ECA-UFSC-FLN/2026.1-G7-RoboColetorBolas/hardware/pcb/README.md

Coloquei aqui os circuitos desenvolvidos
