ECA-UFSC-FLN/2026.1-G7-RoboColetorBolas/docs/README.md

Pasta para colocar a documentação do projeto
