ECA-UFSC-FLN/2026.1-G7-RoboColetorBolas/hardware/3d-models/README.md

Coloque aqui os arquivos para impressão 3D.
