ECA-UFSC-FLN/2026.1-G7-RoboColetorBolas/src/runs/detect/treino_bolas_v24/BoxR_curve.png

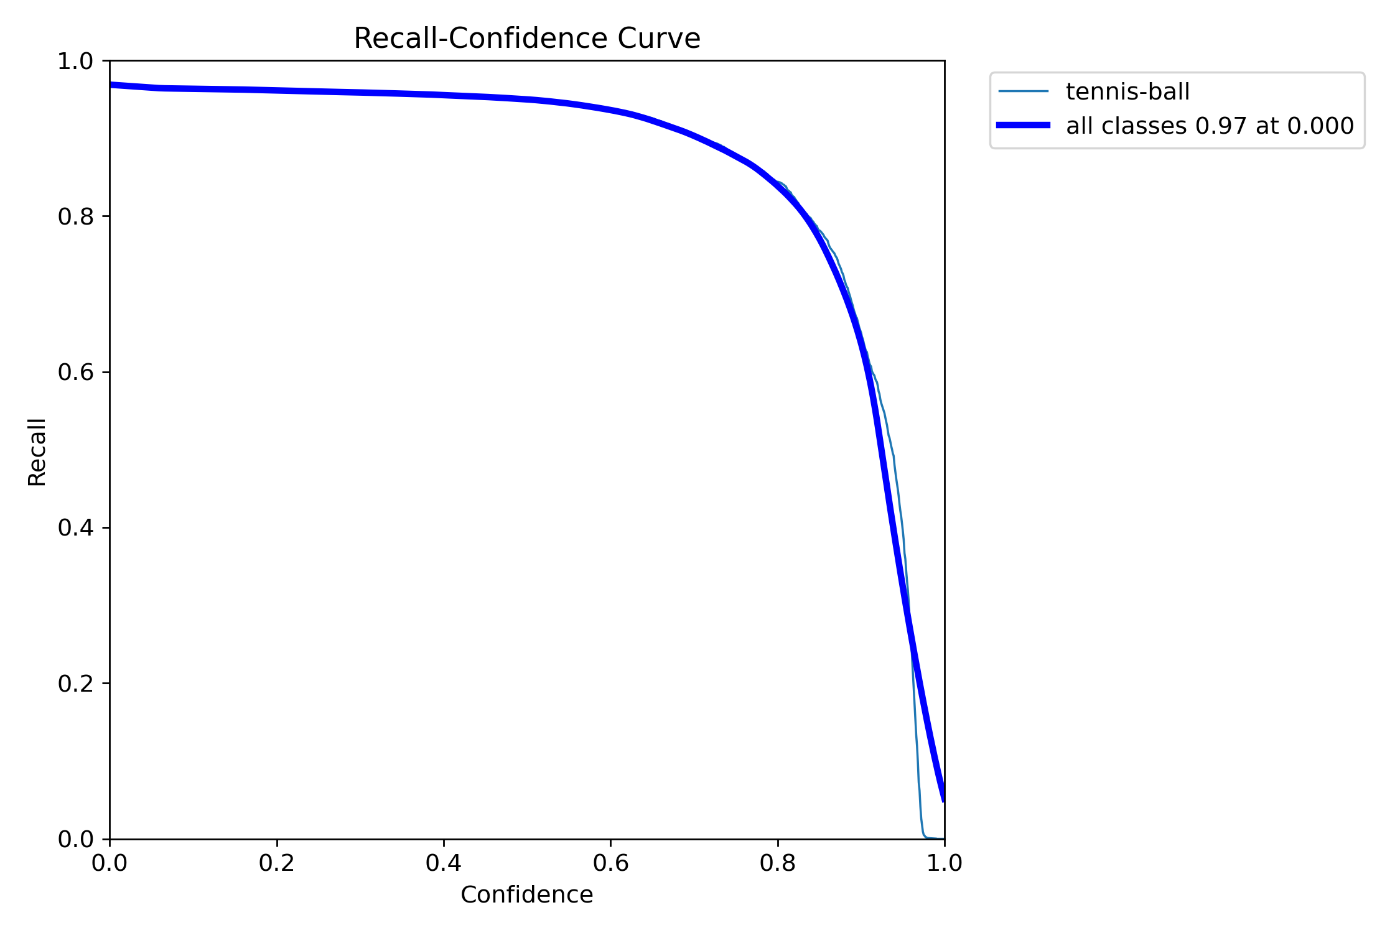
src/runs/detect/treino_bolas_v24/BoxR_curve.png
