ECA-UFSC-FLN/2026.1-G7-RoboColetorBolas/src/runs/detect/treino_bolas_v24/train_batch112861.jpg

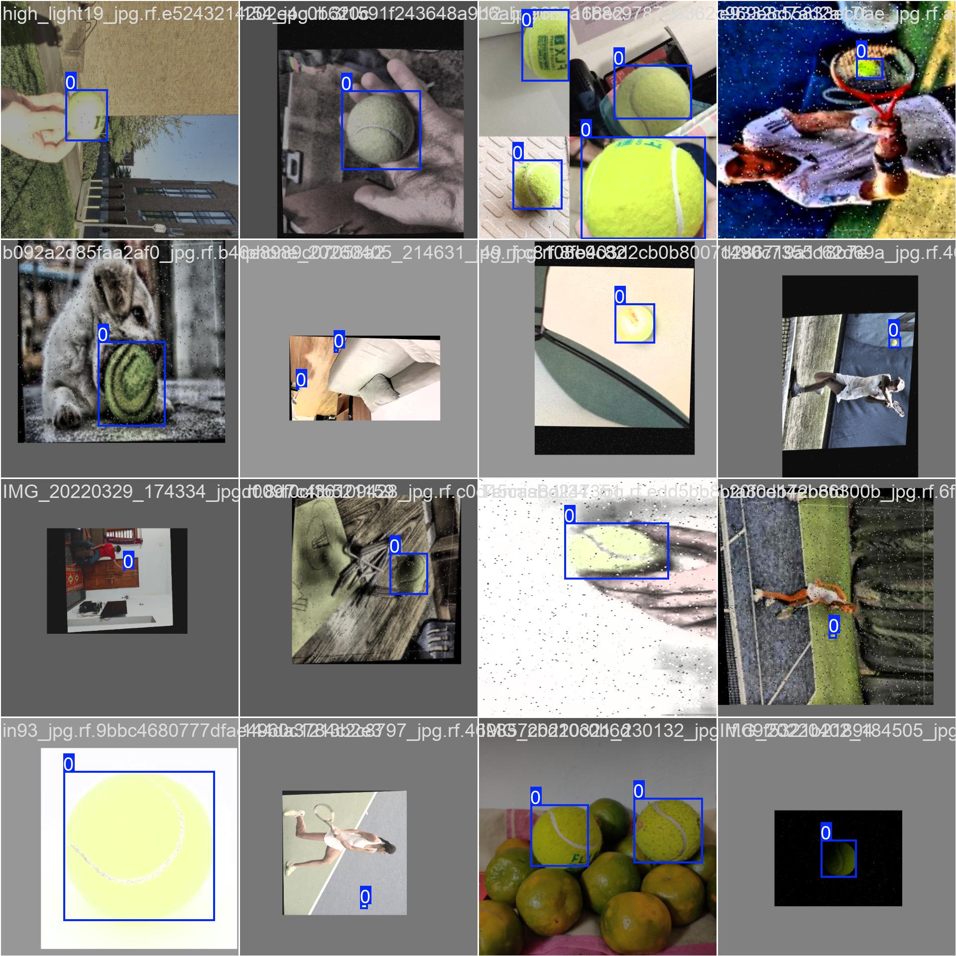
src/runs/detect/treino_bolas_v24/train_batch112861.jpg
