ECA-UFSC-FLN/2026.1-G7-RoboColetorBolas/src/runs/detect/treino_bolas_v24/val_batch1_labels.jpg

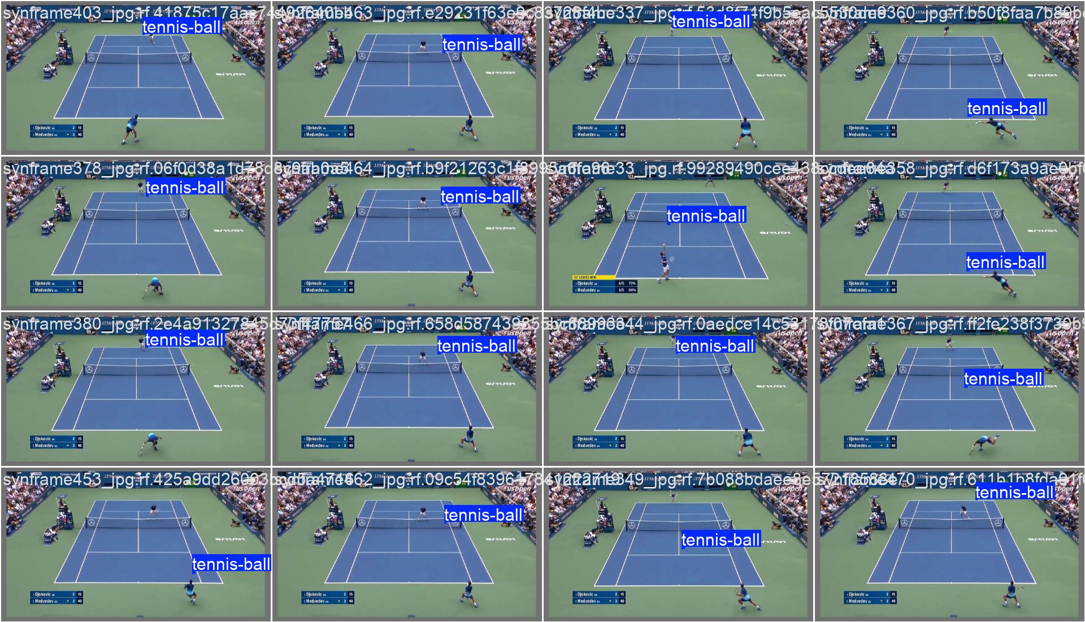
src/runs/detect/treino_bolas_v24/val_batch1_labels.jpg
