ECA-UFSC-FLN/2026.1-G7-RoboColetorBolas/docs/Entrega2/Entrega 2 - Projeto Integrador.pdf

# Robô Coletor de

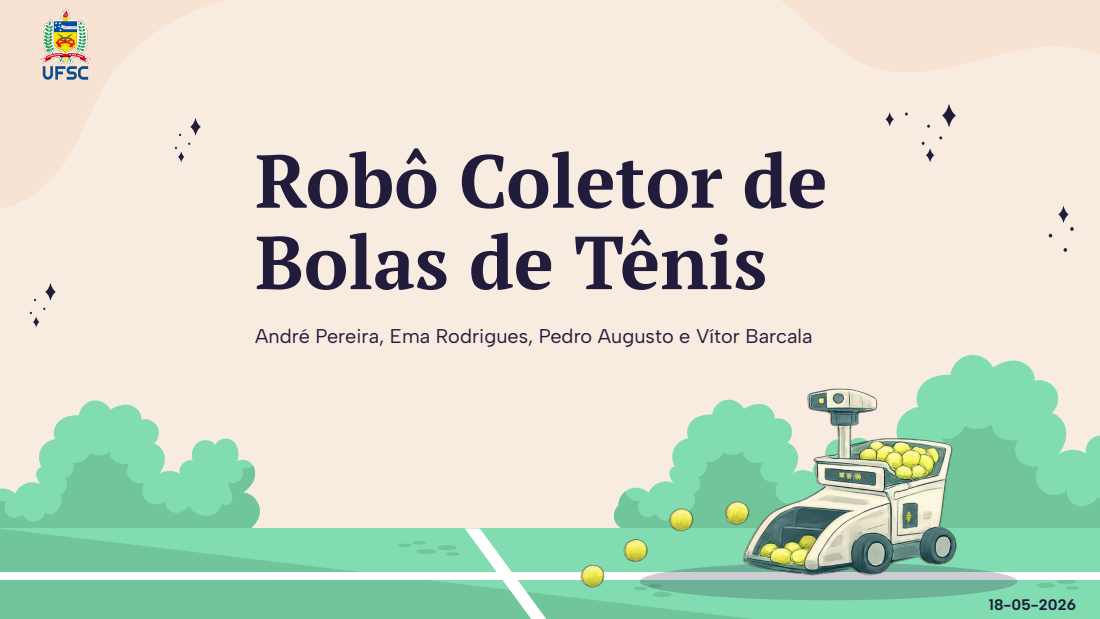
[picture p75: page 1]

Bolas de Tênis

André Pereira, Ema Rodrigues, Pedro Augusto e Vítor Barcala

# Tópicos

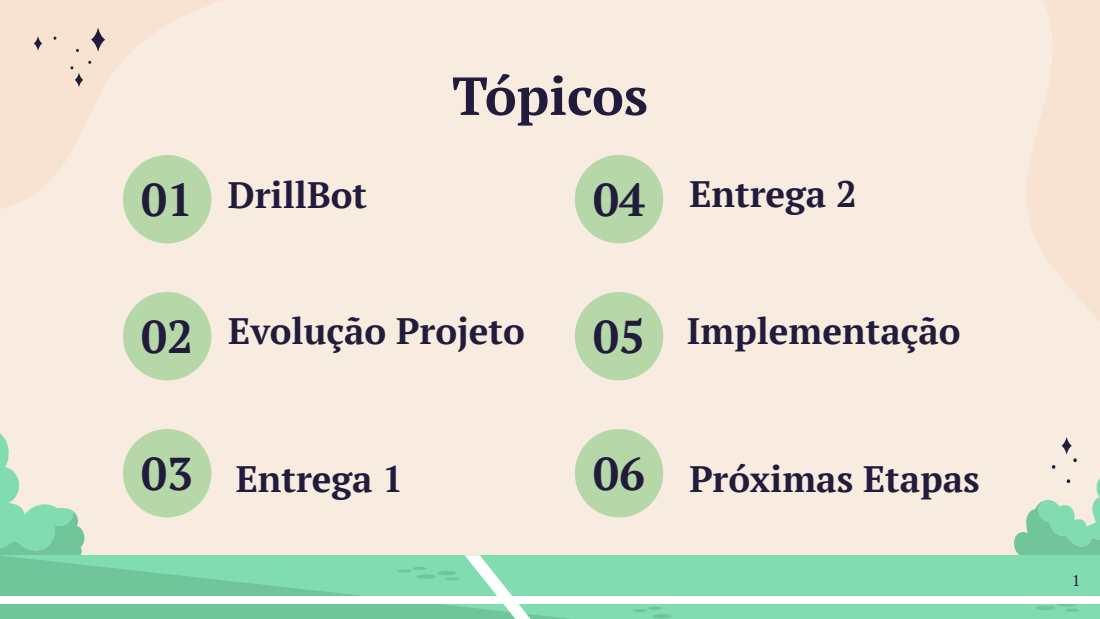
[picture p76: page 2]
Evolução Projeto; DrillBot; Entrega 2; Implementação; Entrega 1; Próximas Etapas

# 01 Drillbot

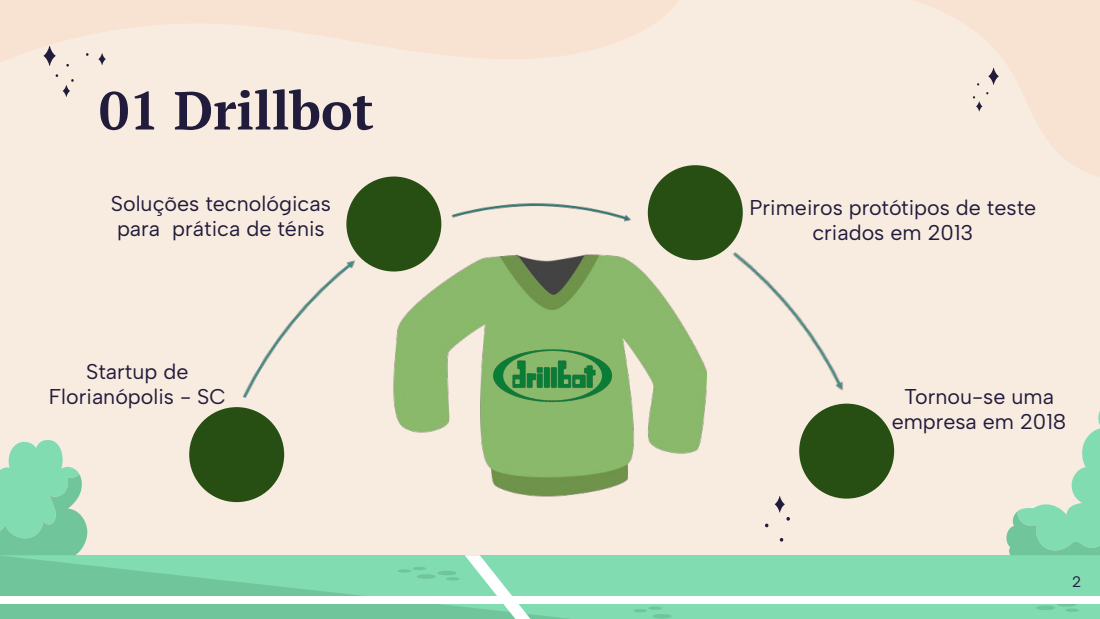
[picture p77: page 3]
Startup de; Florianópolis - SC; Tornou-se uma; empresa em 2018

Soluções tecnológicas
para prática de ténis

Primeiros protótipos de teste
criados em 2013

# Evolução do Projeto

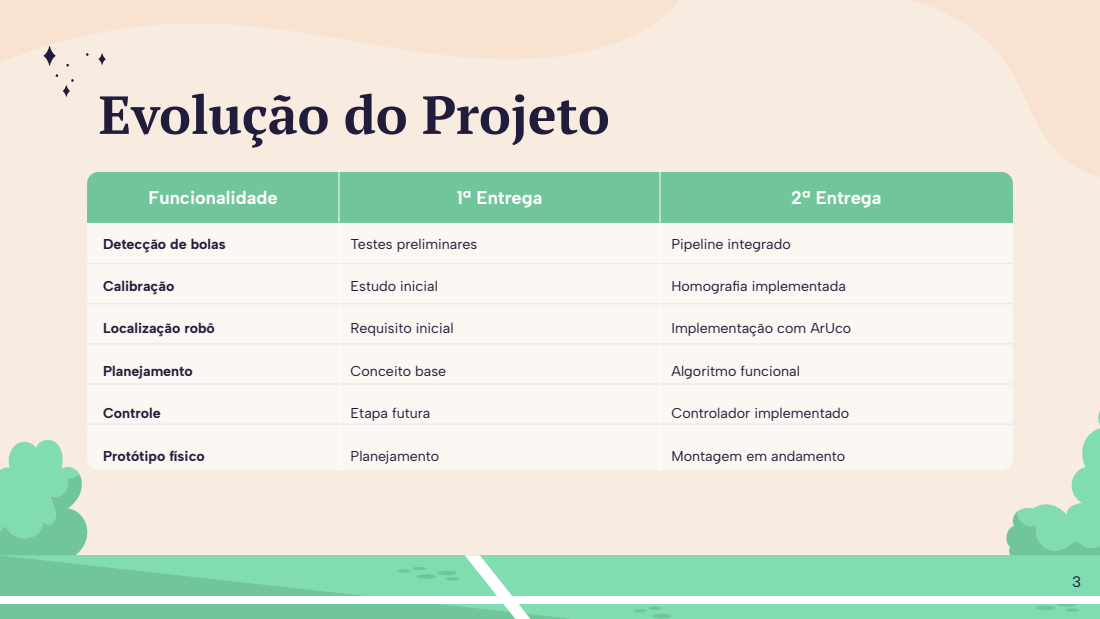
[picture p78: page 4]
Funcionalidade; 1ª Entrega; 2ª Entrega; Testes preliminares; Pipeline integrado

Detecção de bolas

Calibração | Estudo inicial | Homografia implementada

Localização robô | Requisito inicial | Implementação com ArUco

Planejamento | Conceito base | Algoritmo funcional

Controle | Etapa futura | Controlador implementado

Protótipo físico | Planejamento | Montagem em andamento

# Resumo Entrega 1

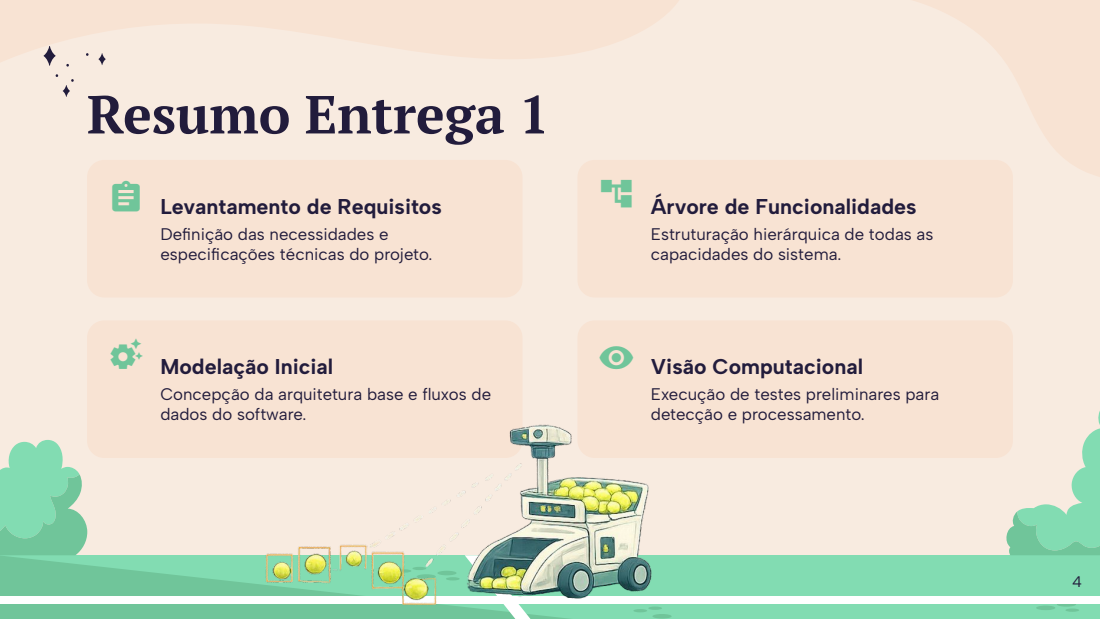
[picture p79: page 5]
Modelação Inicial; Visão Computacional

Árvore de Funcionalidades

Levantamento de Requisitos

Definição das necessidades e
especificações técnicas do projeto.

Estruturação hierárquica de todas as
capacidades do sistema.

Concepção da arquitetura base e fluxos de
dados do software.

Execução de testes preliminares para
detecção e processamento.

# Resumo Entrega 2

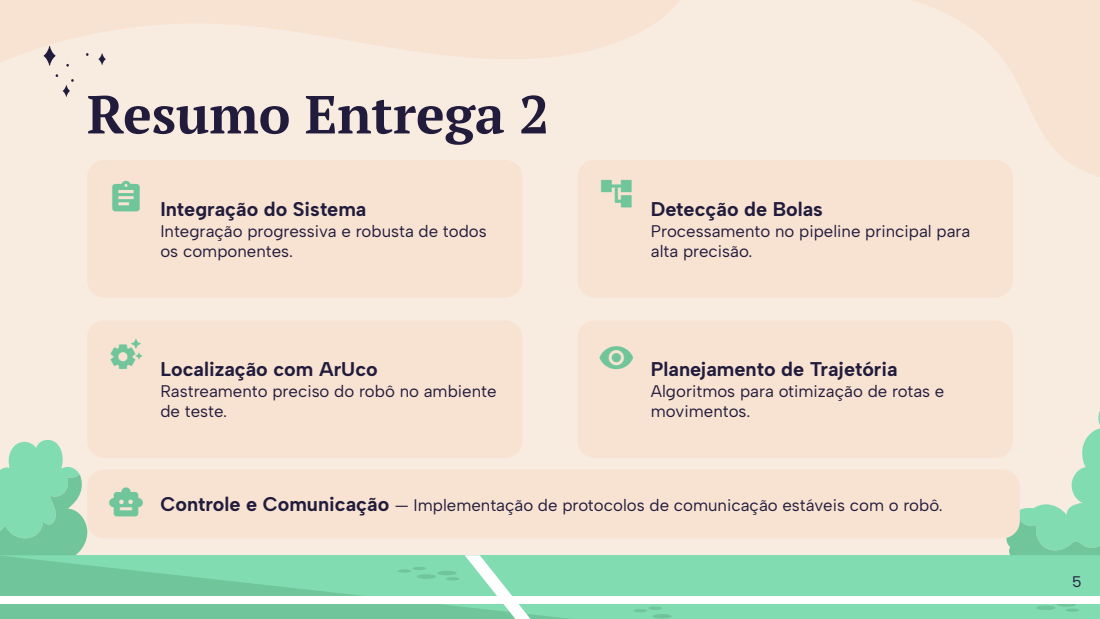
[picture p80: page 6]

Detecção de Bolas

Integração do Sistema

Integração progressiva e robusta de todos
os componentes.

Processamento no pipeline principal para
alta precisão.

Localização com ArUco

Planejamento de Trajetória
Algoritmos para otimização de rotas e
movimentos.

Rastreamento preciso do robô no ambiente
de teste.

Controle e Comunicação — Implementação de protocolos de comunicação estáveis com o robô.

# Arquitetura Geral

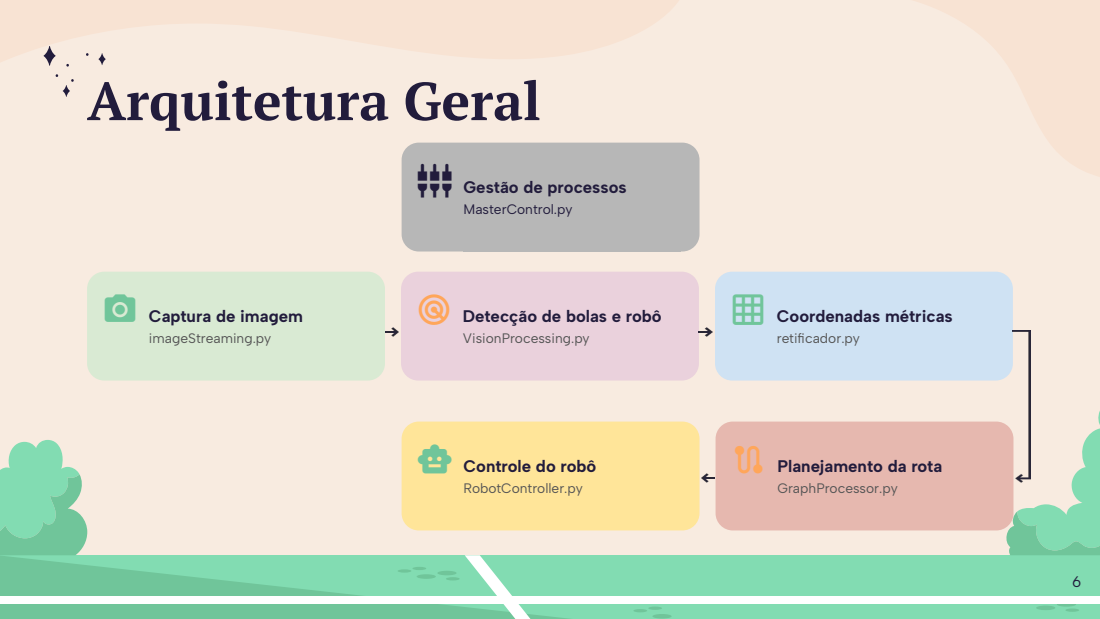
[picture p81: page 7]
imageStreaming.py; VisionProcessing.py; Coordenadas métricas; retificador.py; MasterControl.py; GraphProcessor.py

Gestão de processos

Captura de imagem

Detecção de bolas e robô

Planejamento da rota
Controle do robô
RobotController.py

# Captura de Imagem

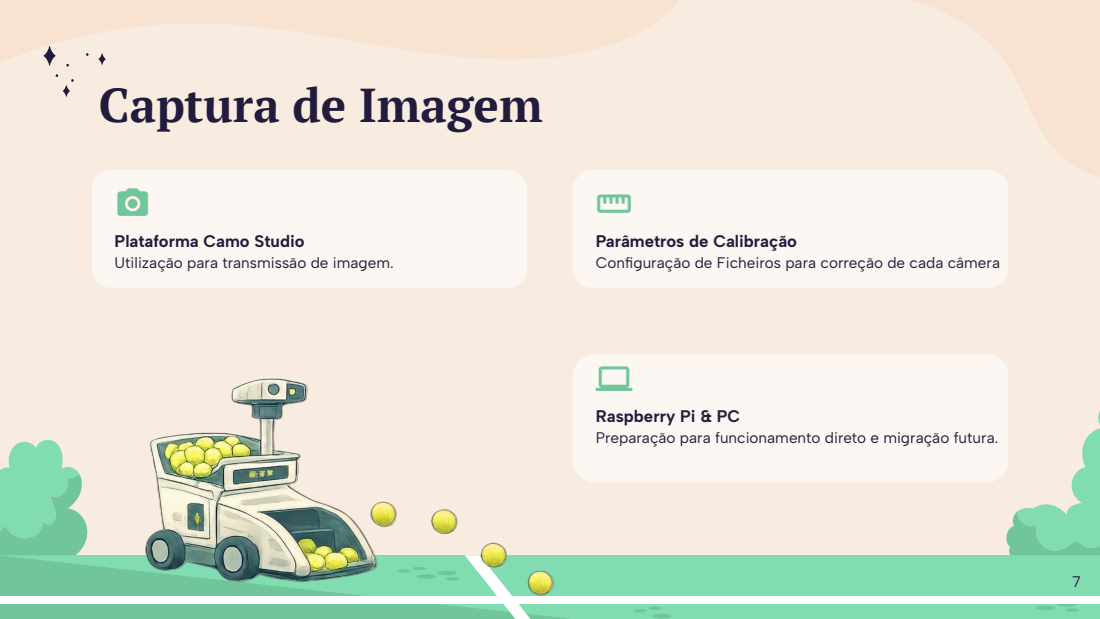
[picture p82: page 8]

Plataforma Camo Studio
Utilização para transmissão de imagem.

Parâmetros de Calibração
Configuração de Ficheiros para correção de cada câmera

Raspberry Pi & PC
Preparação para funcionamento direto e migração futura.

# Calibração e Homografia

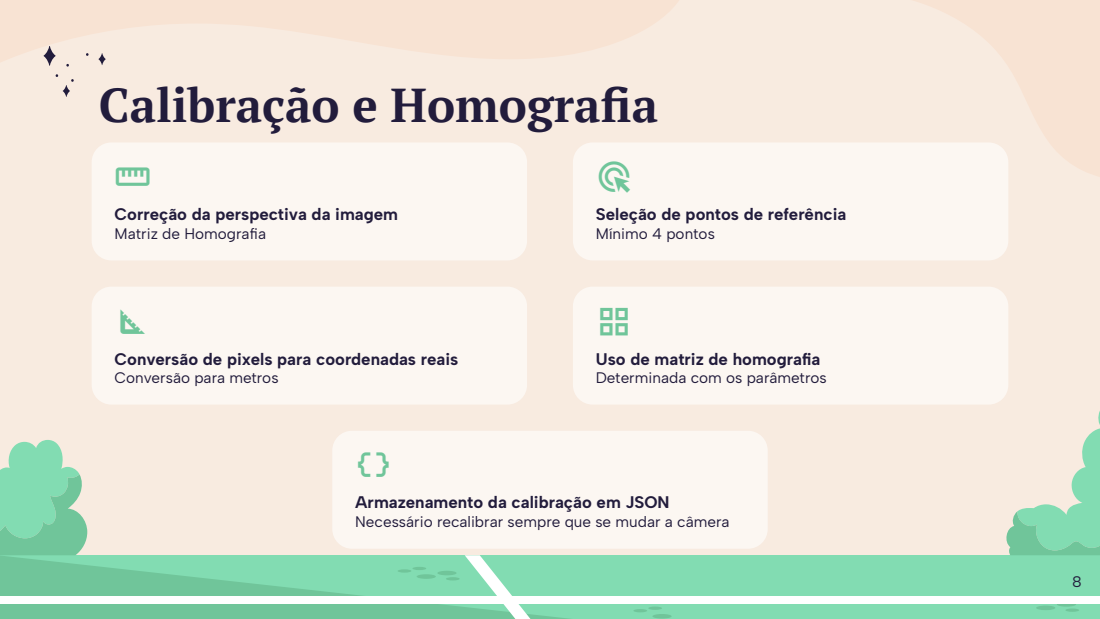
[picture p83: page 9]

Correção da perspectiva da imagem
Matriz de Homografia

Seleção de pontos de referência
Mínimo 4 pontos

Conversão de pixels para coordenadas reais
Conversão para metros

Uso de matriz de homografia
Determinada com os parâmetros

Armazenamento da calibração em JSON
Necessário recalibrar sempre que se mudar a câmera

# Deteção de Bolas

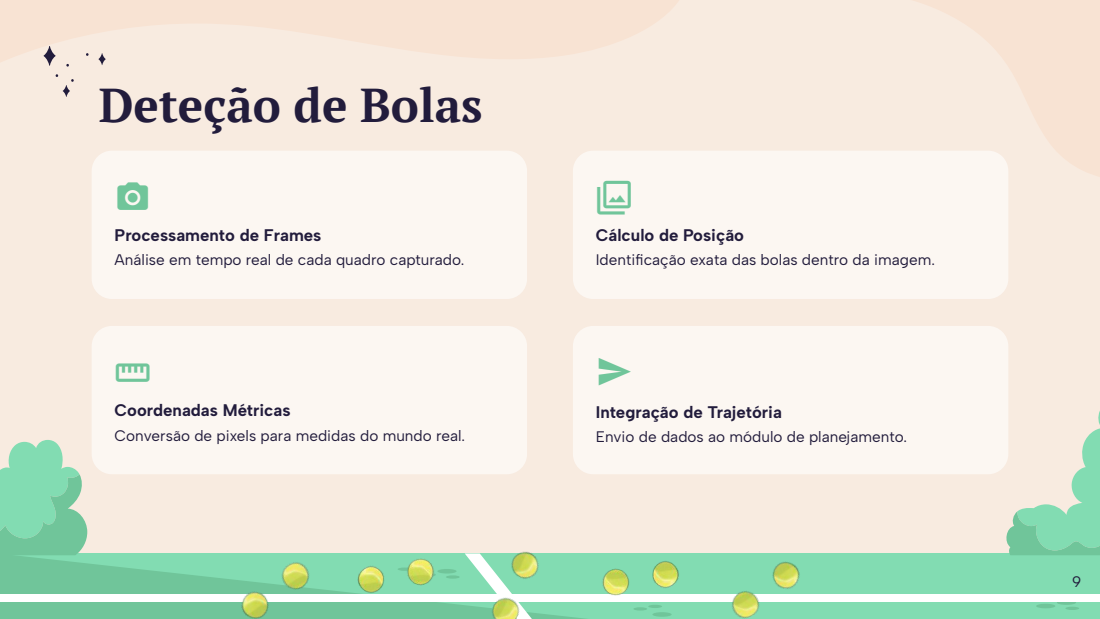
[picture p84: page 10]

Processamento de Frames
Análise em tempo real de cada quadro capturado.

Cálculo de Posição
Identificação exata das bolas dentro da imagem.

Coordenadas Métricas
Conversão de pixels para medidas do mundo real.

Integração de Trajetória
Envio de dados ao módulo de planejamento.

# Localização do Robô

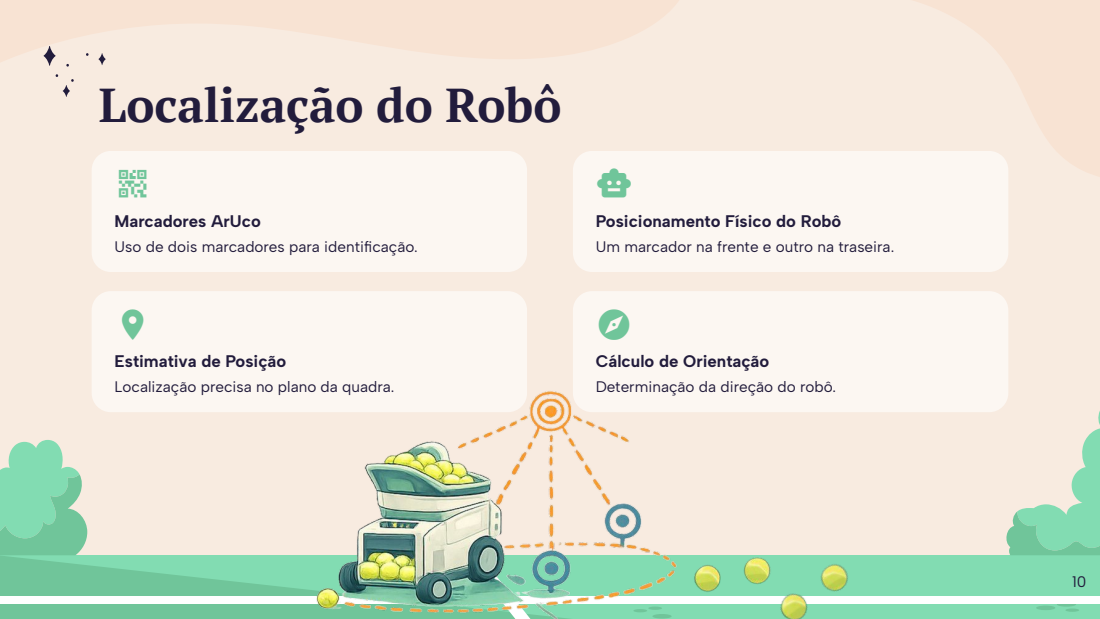
[picture p85: page 11]

Marcadores ArUco
Uso de dois marcadores para identificação.

Posicionamento Físico do Robô
Um marcador na frente e outro na traseira.

Estimativa de Posição
Localização precisa no plano da quadra.

Cálculo de Orientação
Determinação da direção do robô.

# Planejamento da Trajetória

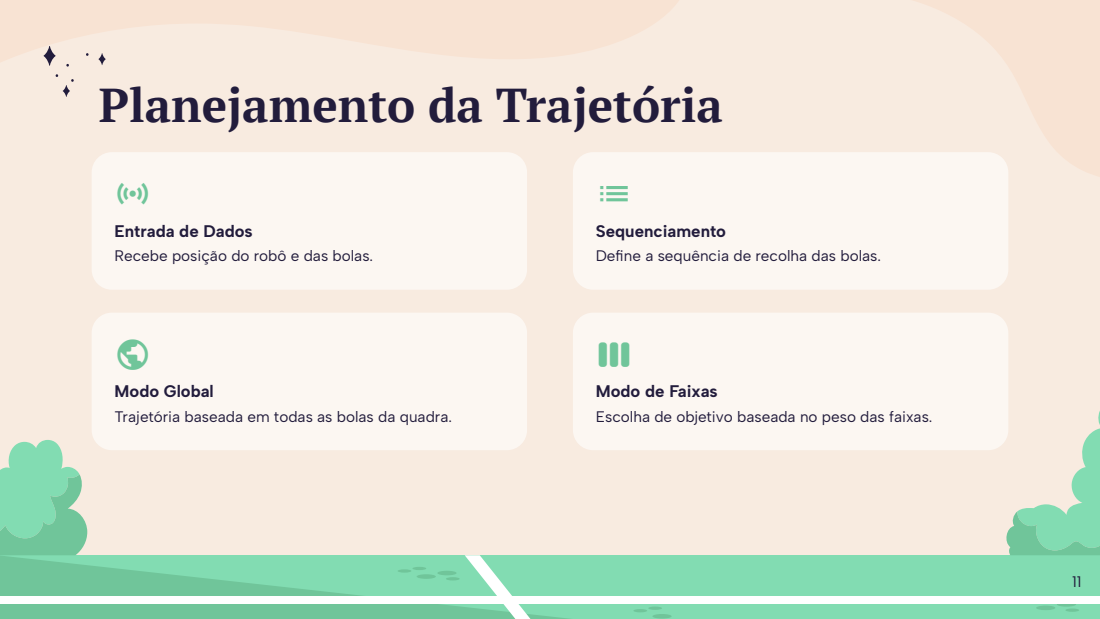
[picture p86: page 12]
_numbe

Entrada de Dados
Recebe posição do robô e das bolas.

Sequenciamento
Define a sequência de recolha das bolas.

Modo Global
Trajetória baseada em todas as bolas da quadra.

Modo de Faixas
Escolha de objetivo baseada no peso das faixas.

# Vídeo Experimental

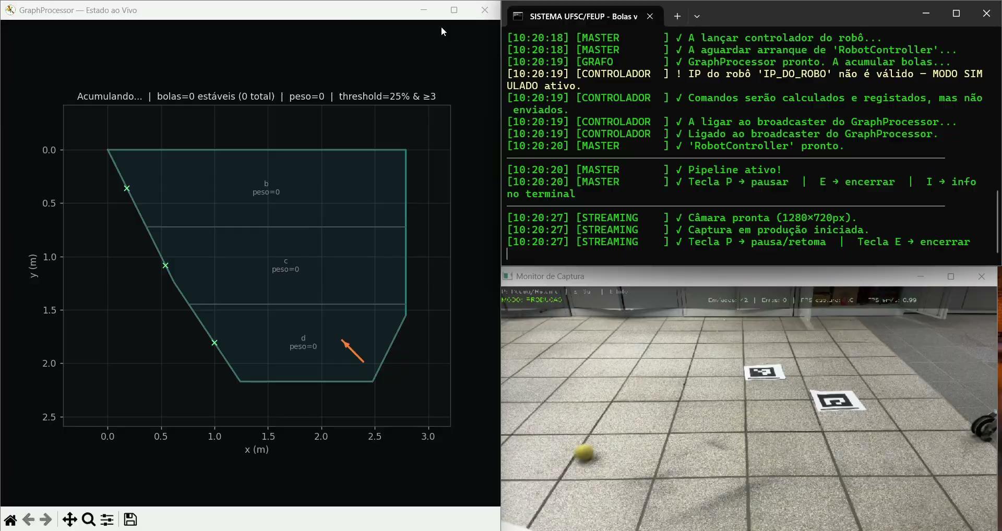
[picture p87: figure]

# Vídeo Experimental

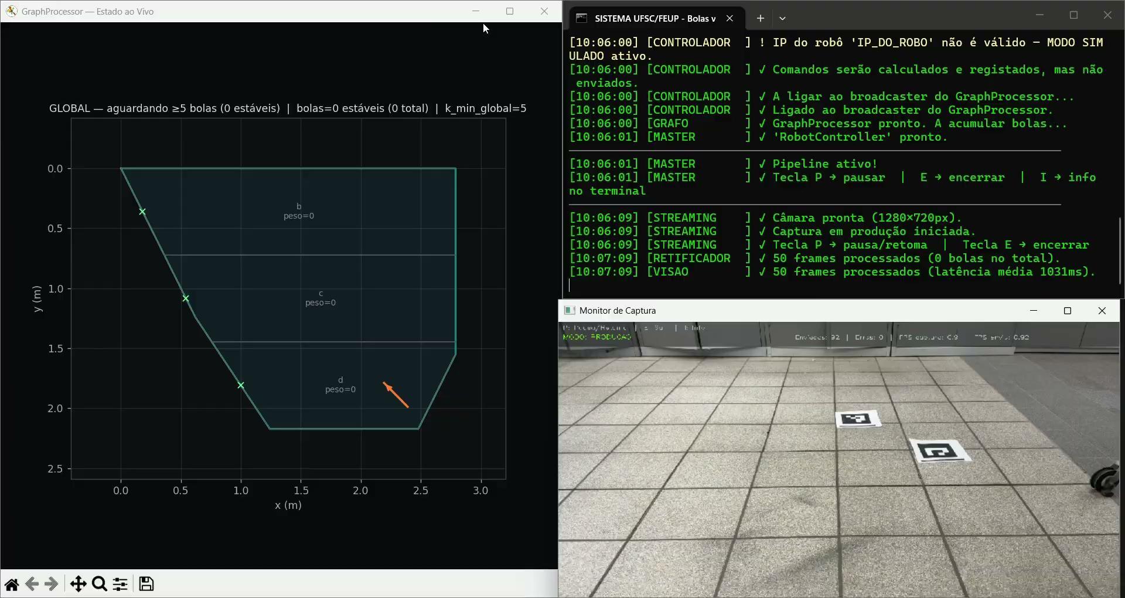
[picture p88: figure]

# Controle de Robô

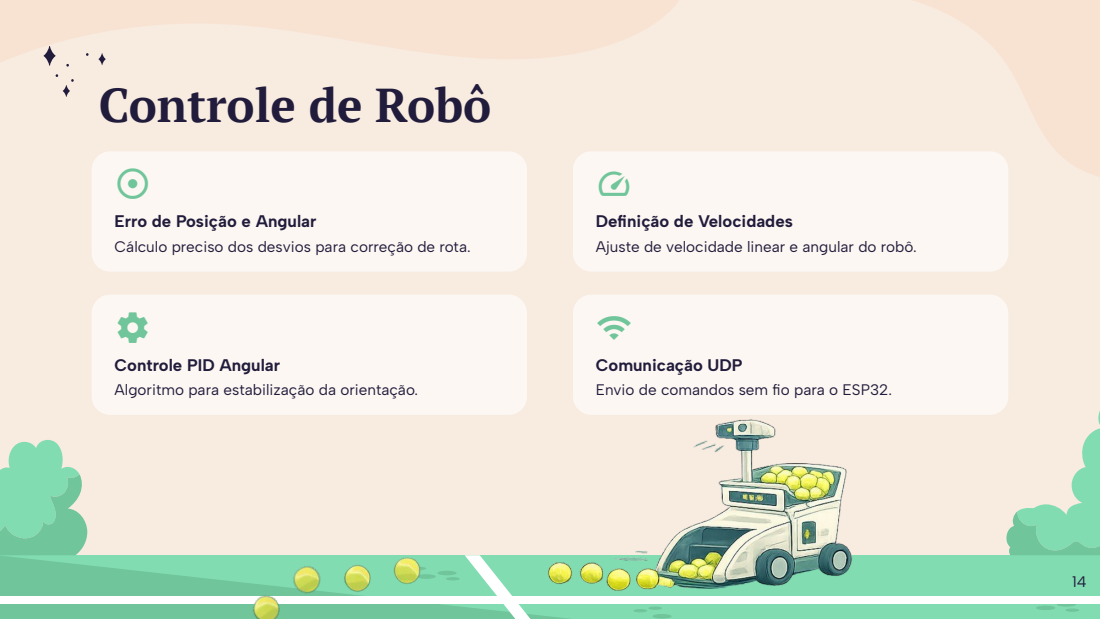
[picture p89: page 15]

Erro de Posição e Angular
Cálculo preciso dos desvios para correção de rota.

Definição de Velocidades
Ajuste de velocidade linear e angular do robô.

Controle PID Angular
Algoritmo para estabilização da orientação.

Comunicação UDP
Envio de comandos sem fio para o ESP32.

# Protótipo Físico

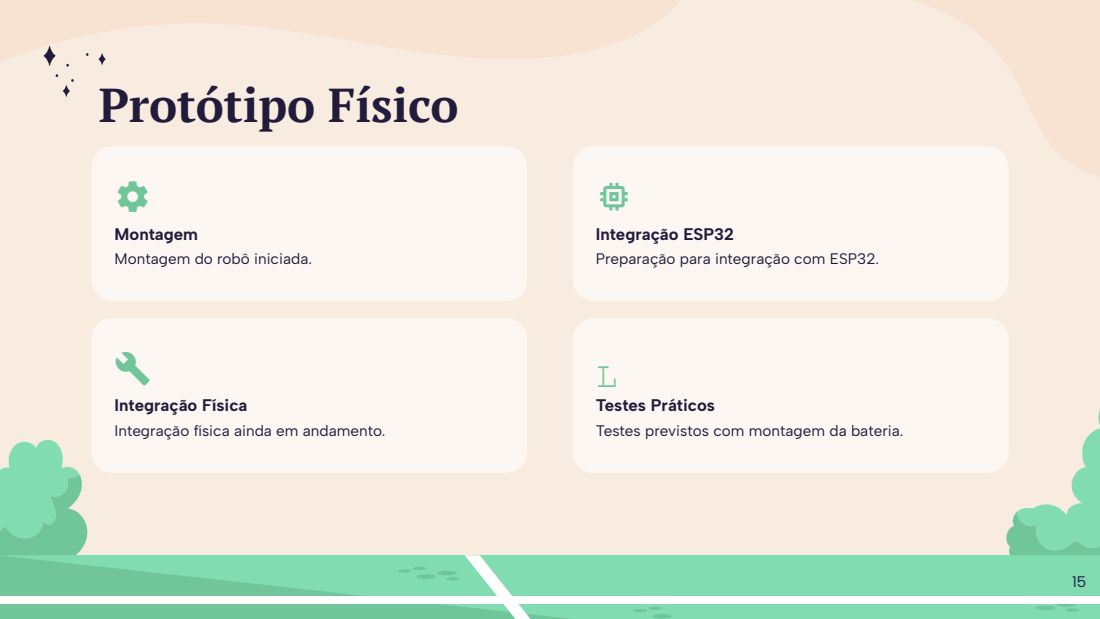
[picture p90: page 16]
List_numbeg Testes Práticos

Montagem
Montagem do robô iniciada.

Integração ESP32
Preparação para integração com ESP32.

Integração Física
Integração física ainda em andamento.

Testes previstos com montagem da bateria.

# Vídeo Experimental

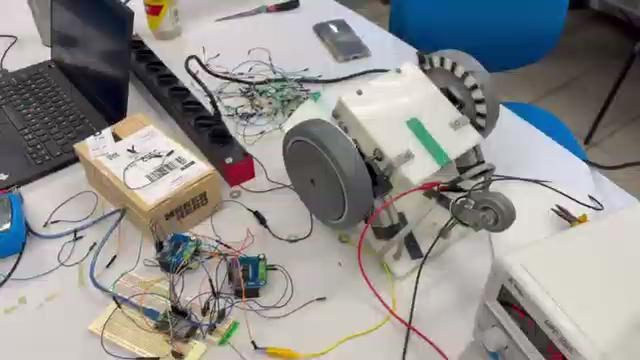
[picture p91: figure]

# Cronograma (Atual)

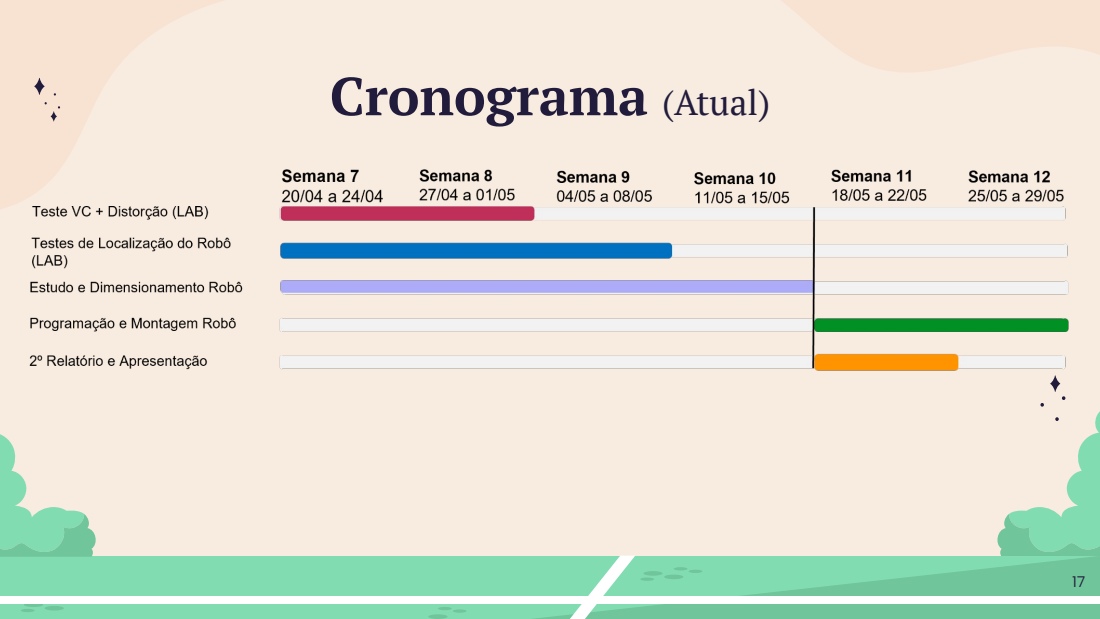
[picture p92: page 18]

# Próximas Etapas

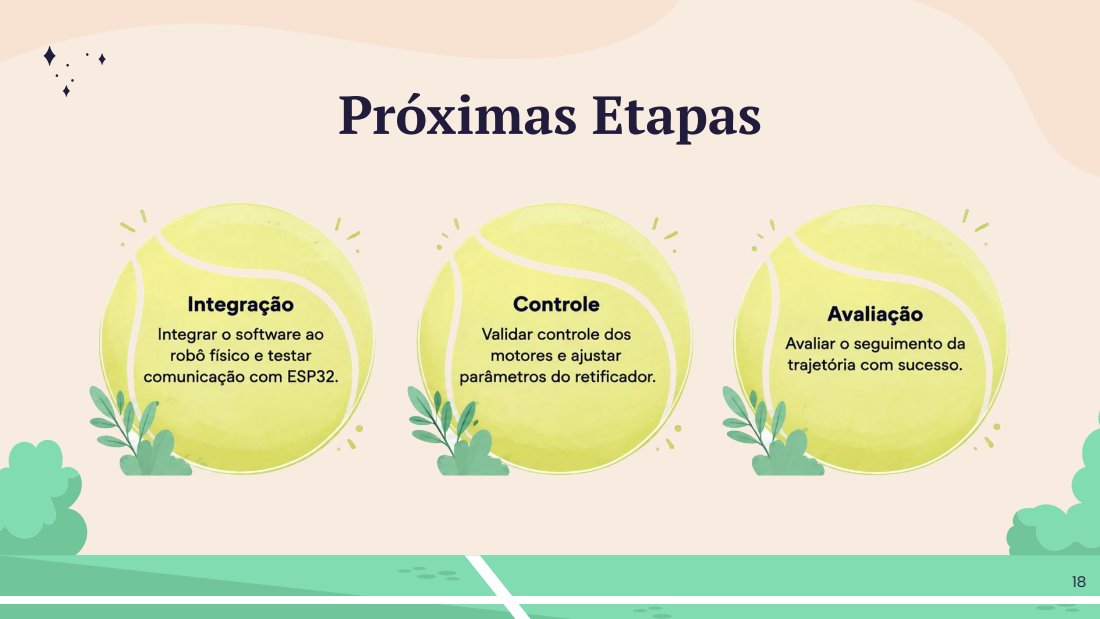
[picture p93: page 19]

# Cronograma (Espectável)

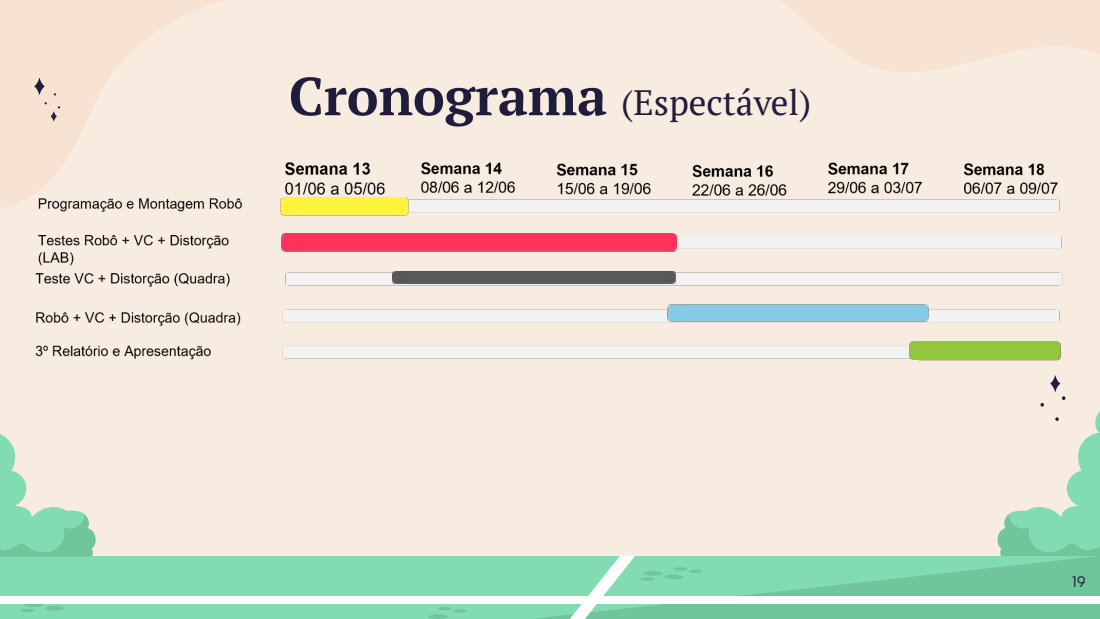
[picture p94: page 20]

# Obrigado!

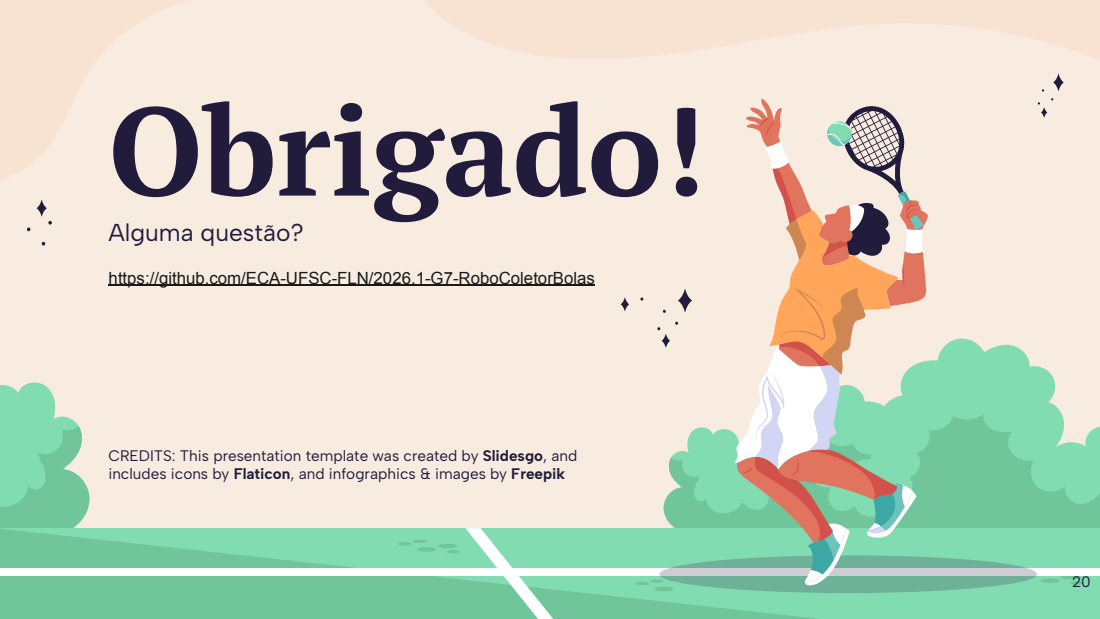
[picture p95: page 21]
Alguma questão?

https://github.com/ECA-UFSC-FLN/2026.1-G7-RoboColetorBolas

CREDITS: This presentation template was created by Slidesgo, (https://bit.ly/3A1uf1Q) and
includes icons by Flaticon, (http://bit.ly/2TyoMsr) and infographics & images by Freepik (http://bit.ly/2TtBDfr)

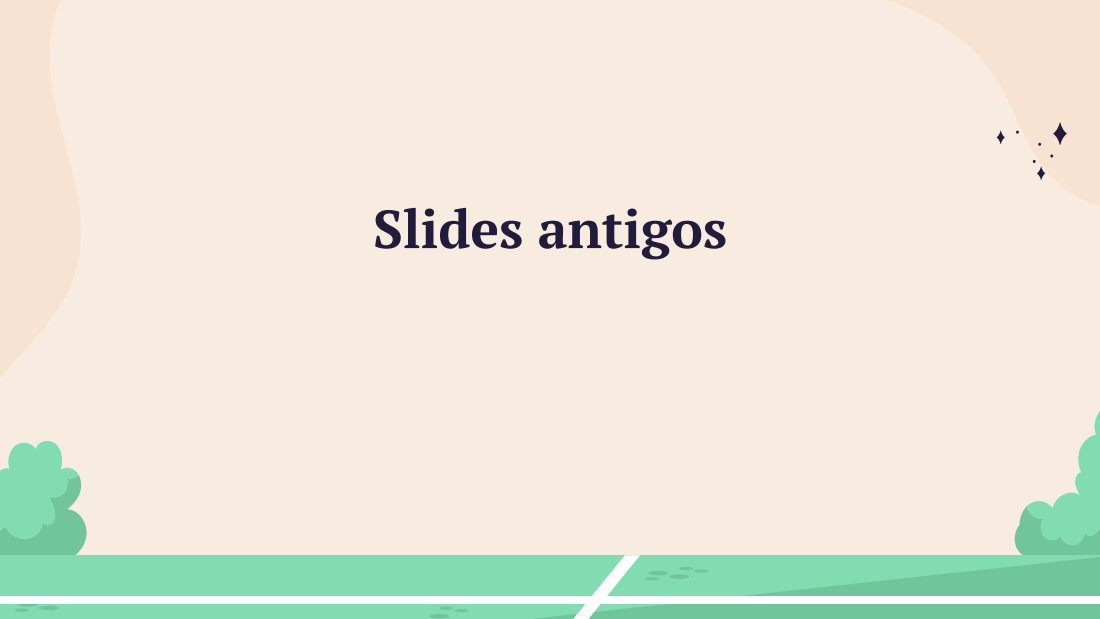
[picture p96: page 22]
Slides antigos

# Tecnologia Atual Drillbot

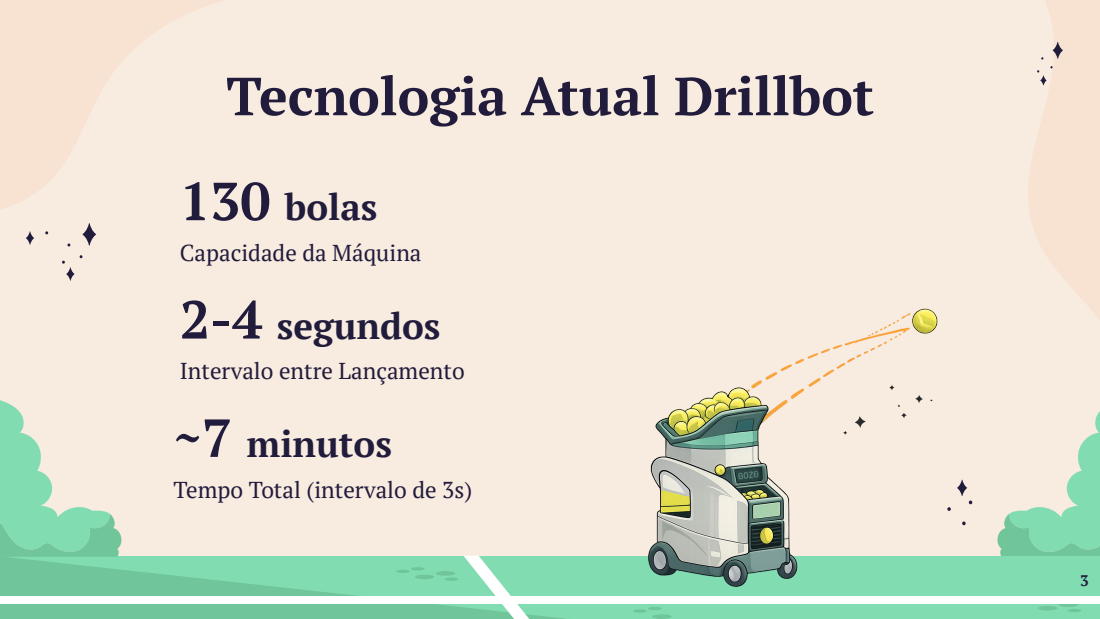
[picture p97: page 23]
130 bolas

Capacidade da Máquina
2-4 segundos

Intervalo entre Lançamento
~7 minutos

Tempo Total (intervalo de 3s)

# 03 Solução Proposta

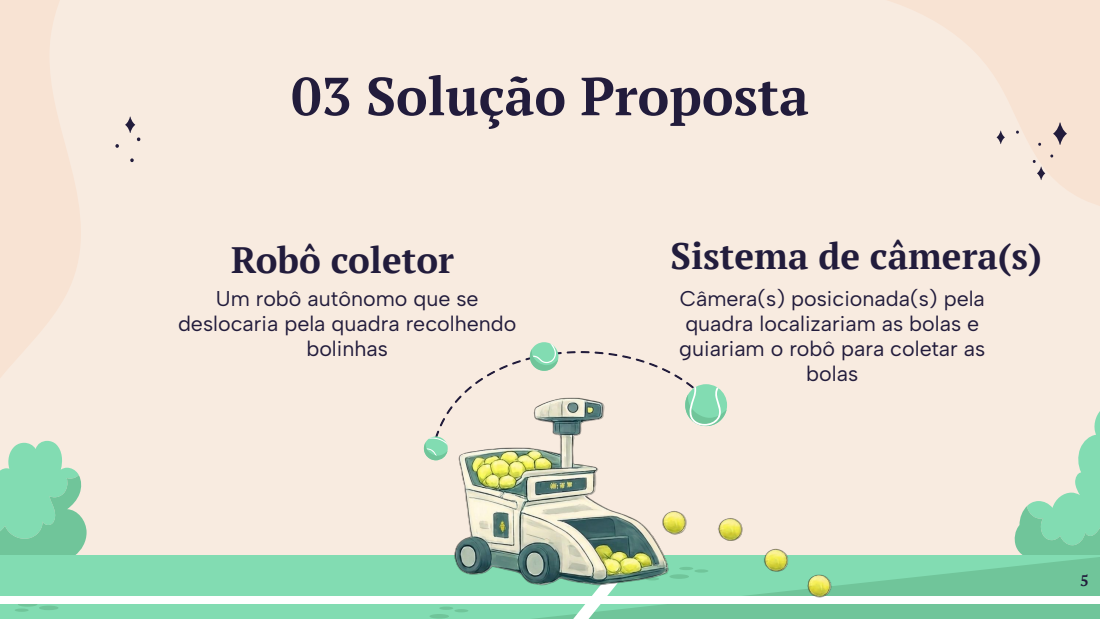
[picture p98: page 24]
bolinhas; bolas; Robô coletor; Sistema de câmera(s)

Um robô autônomo que se
deslocaria pela quadra recolhendo

Câmera(s) posicionada(s) pela
quadra localizariam as bolas e
guiariam o robô para coletar as

# 04 Funcionamento do Sistema

# Captura de Imagem

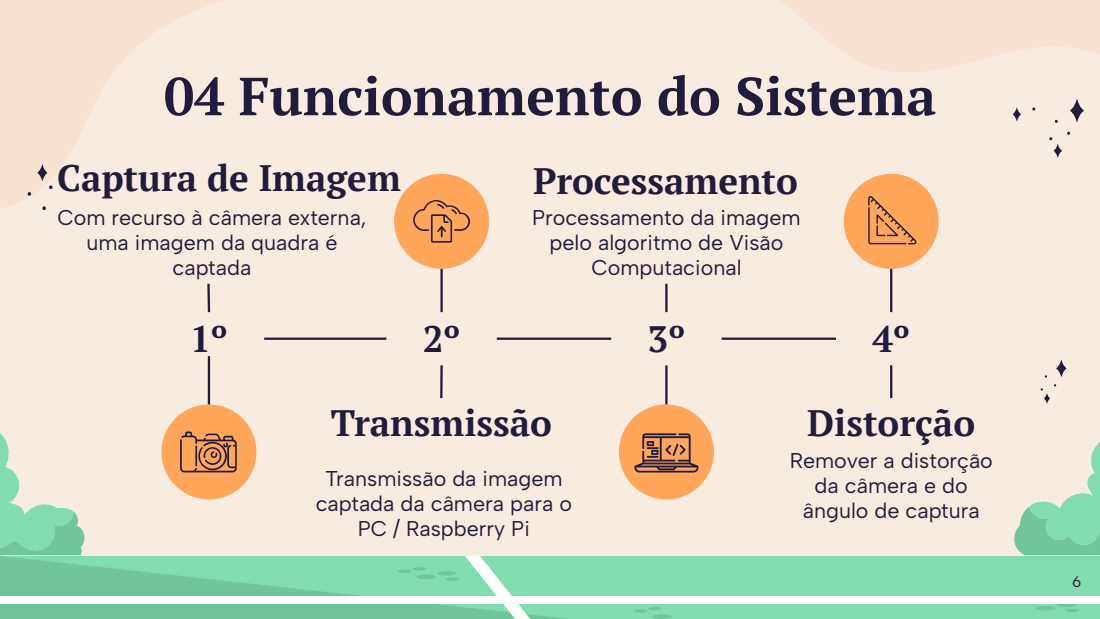
[picture p99: page 25]
captada

Processamento
Processamento da imagem
pelo algoritmo de Visão
Computacional

Com recurso à câmera externa,
uma imagem da quadra é
Transmissão

Distorção
Remover a distorção
da câmera e do
ângulo de captura

Transmissão da imagem
captada da câmera para o
PC / Raspberry Pi

# 04 Funcionamento do Sistema

# Coordenadas

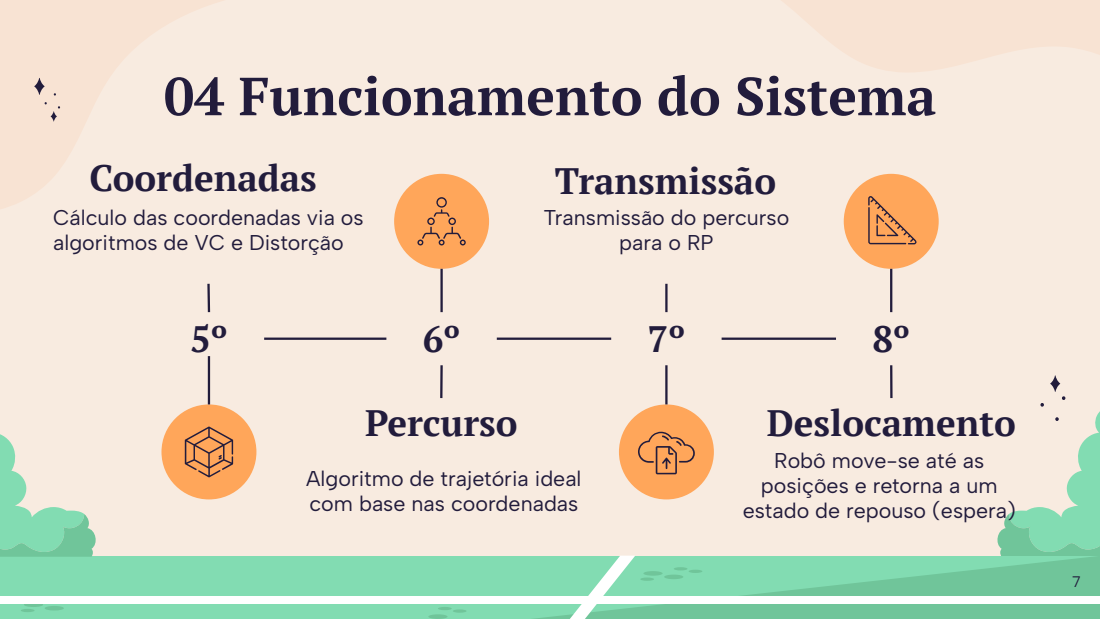
[picture p100: page 26]
Percurso

Transmissão
Transmissão do percurso
para o RP

Cálculo das coordenadas via os
algoritmos de VC e Distorção

Deslocamento
Robô move-se até as
posições e retorna a um
estado de repouso (espera)

Algoritmo de trajetória ideal
com base nas coordenadas

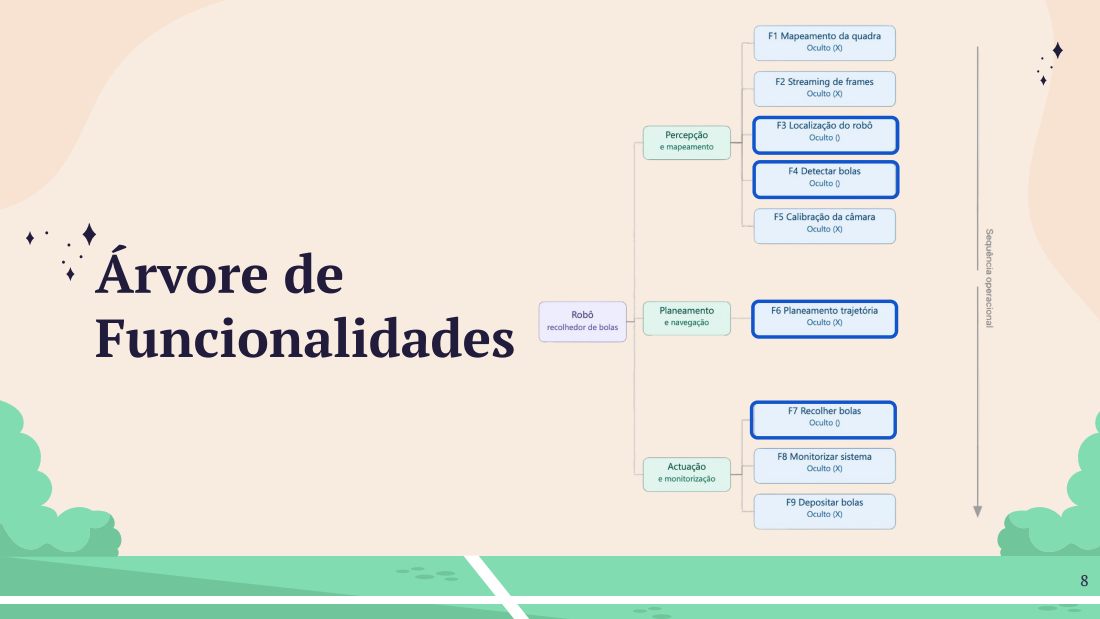
[picture p101: page 27]
Árvore de Funcionalidades

# 05 Requisitos

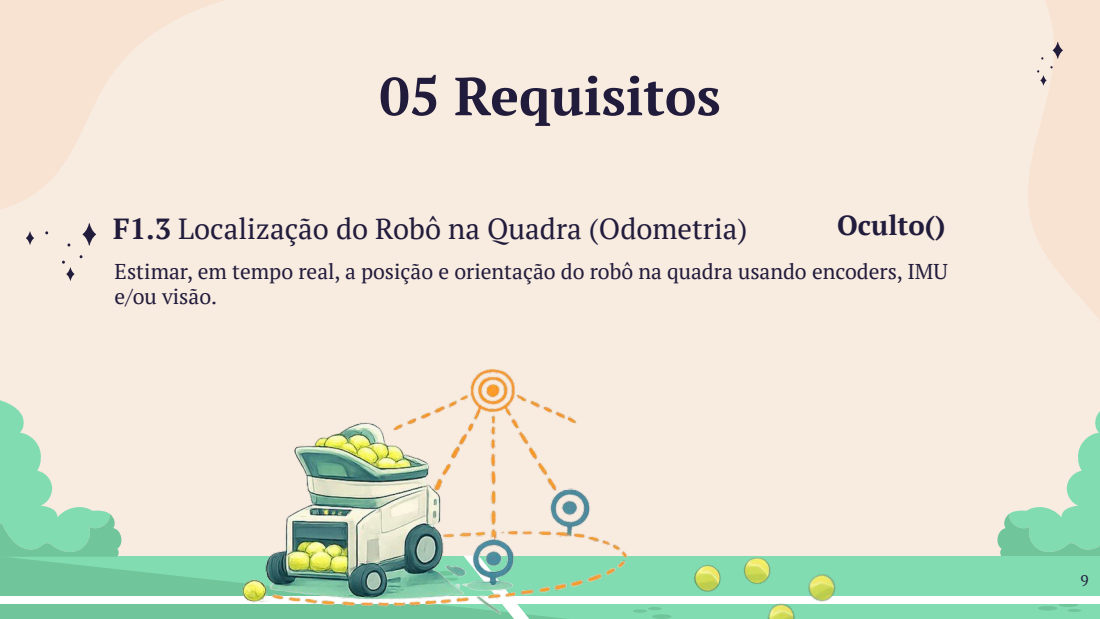
[picture p102: page 28]
Oculto()

F1.3 Localização do Robô na Quadra (Odometria)
Estimar, em tempo real, a posição e orientação do robô na quadra usando encoders, IMU
e/ou visão.

# Requisitos Não Funcionais

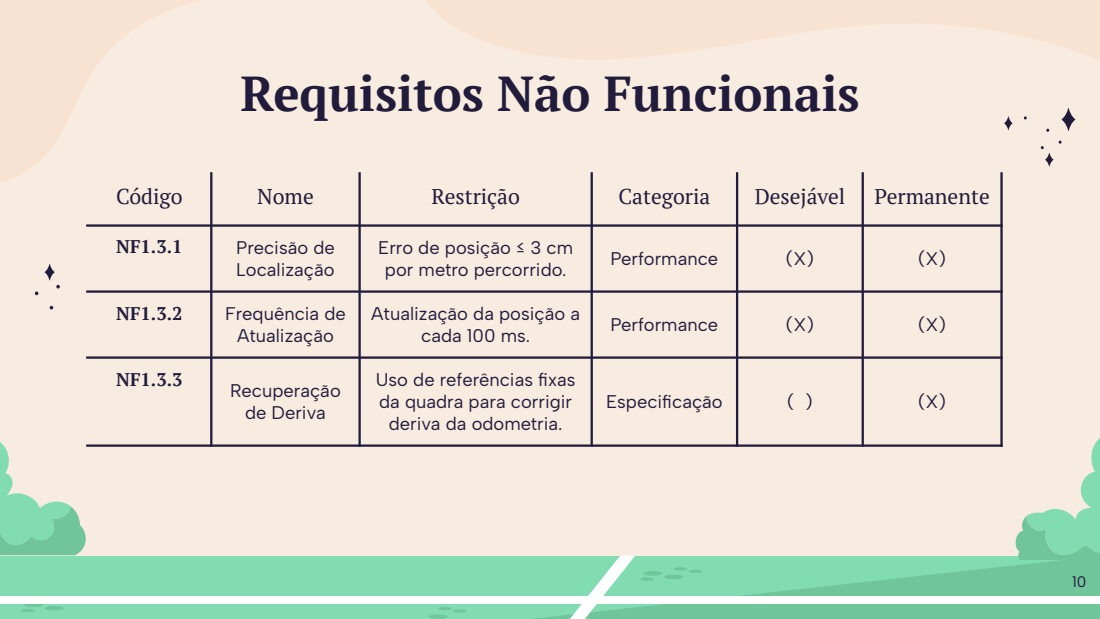
[picture p103: page 29]
Código; Nome; Restrição; Categoria; Desejável; Permanente; Precisão de; Localização; por metro percorrido.; Performance; Frequência de; Atualização; cada 100 ms.; Recuperação; de Deriva; Especificação

Erro de posição ≤ 3 cm

Atualização da posição a

Uso de referências fixas
da quadra para corrigir
deriva da odometria.

# 05 Requisitos

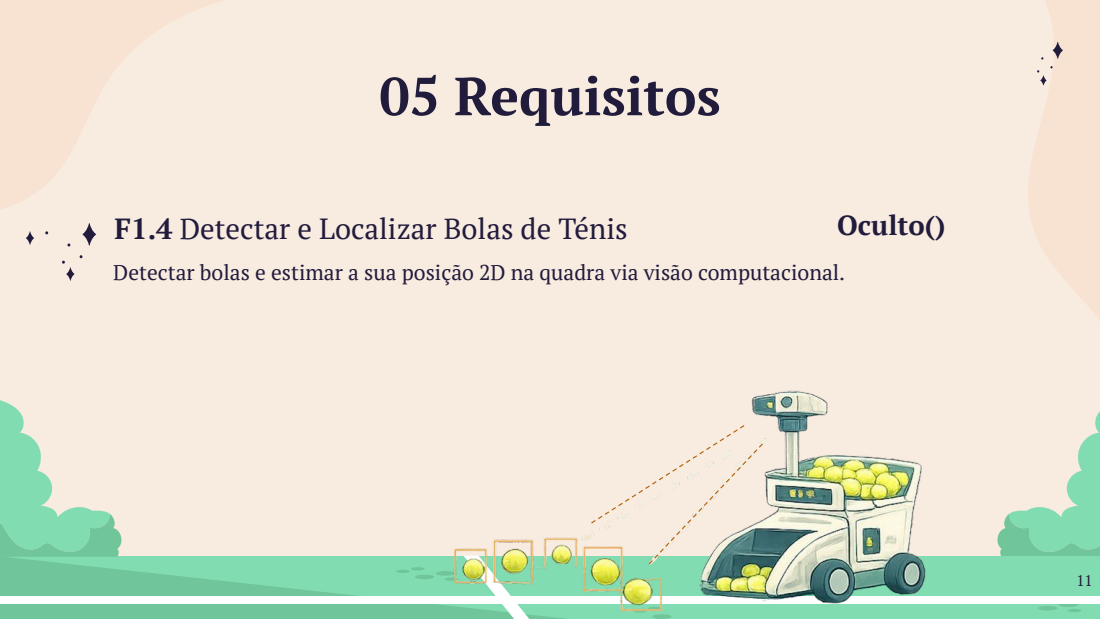
[picture p104: page 30]
Oculto()

F1.4 Detectar e Localizar Bolas de Ténis
Detectar bolas e estimar a sua posição 2D na quadra via visão computacional.

# Requisitos Não Funcionais

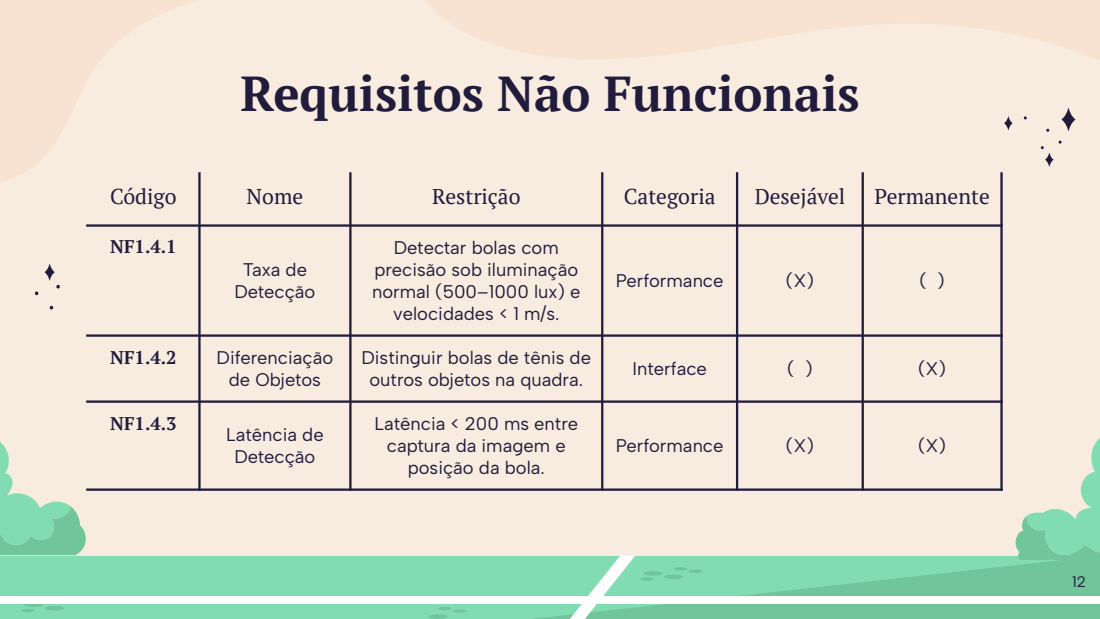
[picture p105: page 31]
Código; Nome; Restrição; Categoria; Desejável; Permanente; Taxa de Detecção; Performance; Diferenciação; de Objetos; outros objetos na quadra.; Interface; Latência de; Detecção

Detectar bolas com
precisão sob iluminação
normal (500–1000 lux) e
velocidades < 1 m/s.

Distinguir bolas de tênis de

Latência < 200 ms entre
captura da imagem e
posição da bola.

# 05 Requisitos

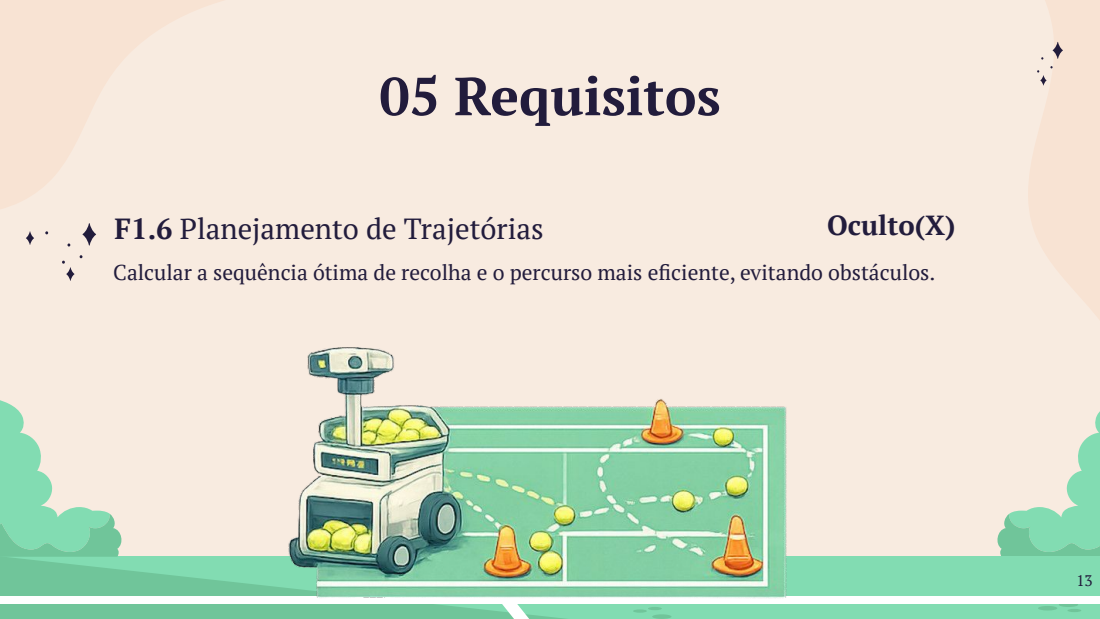
[picture p106: page 32]
Oculto(X)

F1.6 Planejamento de Trajetórias
Calcular a sequência ótima de recolha e o percurso mais eficiente, evitando obstáculos.

# Requisitos Não Funcionais

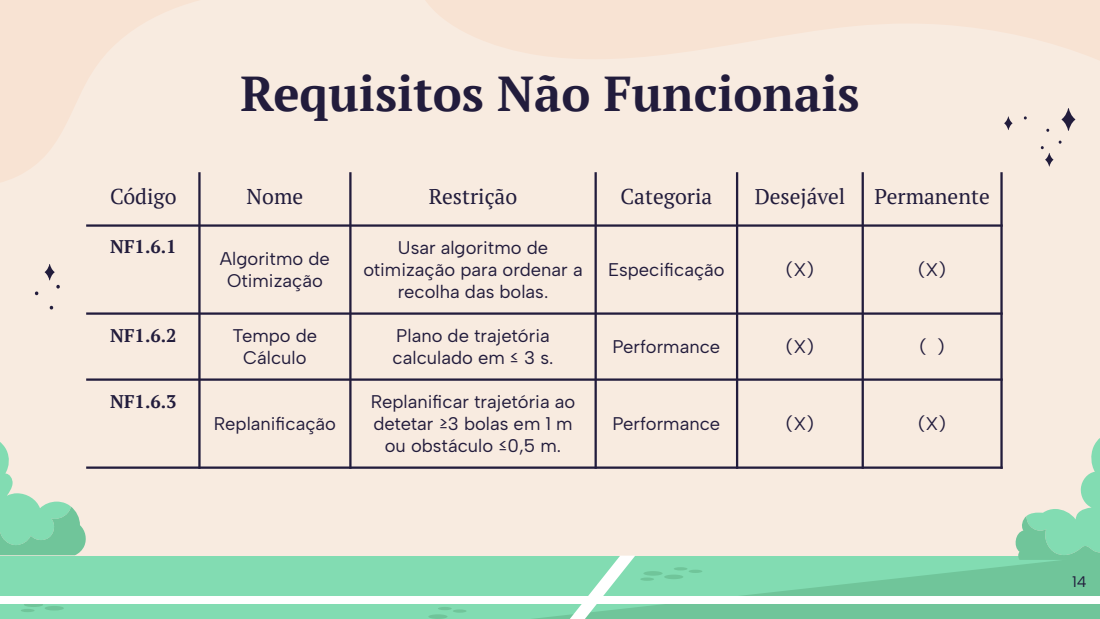
[picture p107: page 33]
Código; Nome; Restrição; Categoria; Desejável; Permanente; Algoritmo de; Otimização; Especificação; Tempo de; Cálculo; calculado em ≤ 3 s.; Performance; Replanificação

Usar algoritmo de
otimização para ordenar a
recolha das bolas.

Plano de trajetória

Replanificar trajetória ao
detetar ≥3 bolas em 1 m
ou obstáculo ≤0,5 m.

# 05 Requisitos

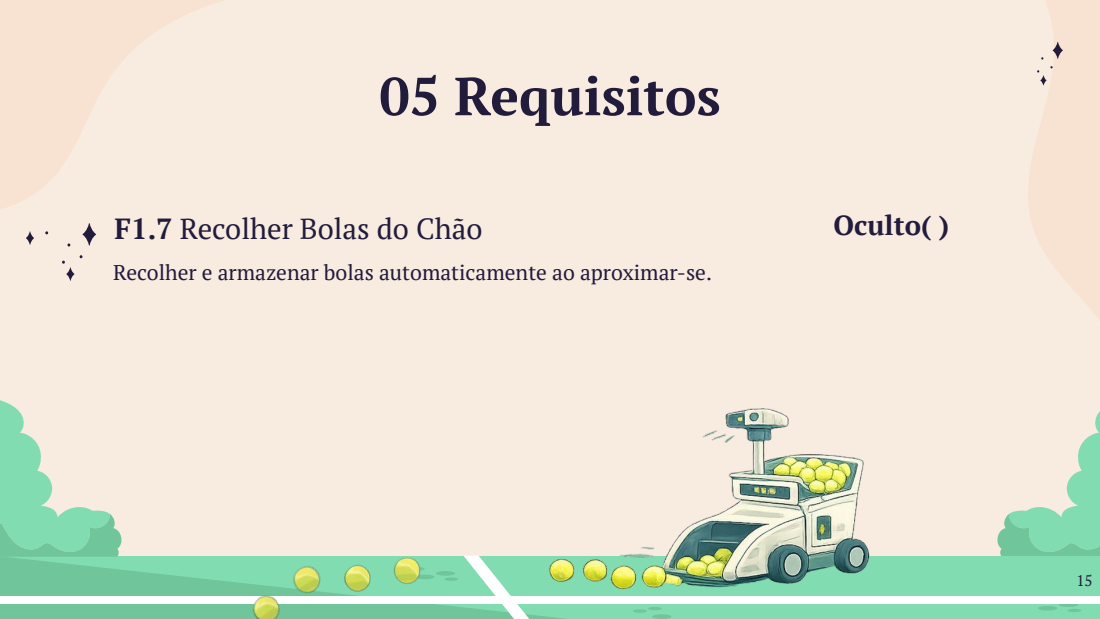
[picture p108: page 34]
Oculto( )

F1.7 Recolher Bolas do Chão
Recolher e armazenar bolas automaticamente ao aproximar-se.

# Requisitos Não Funcionais

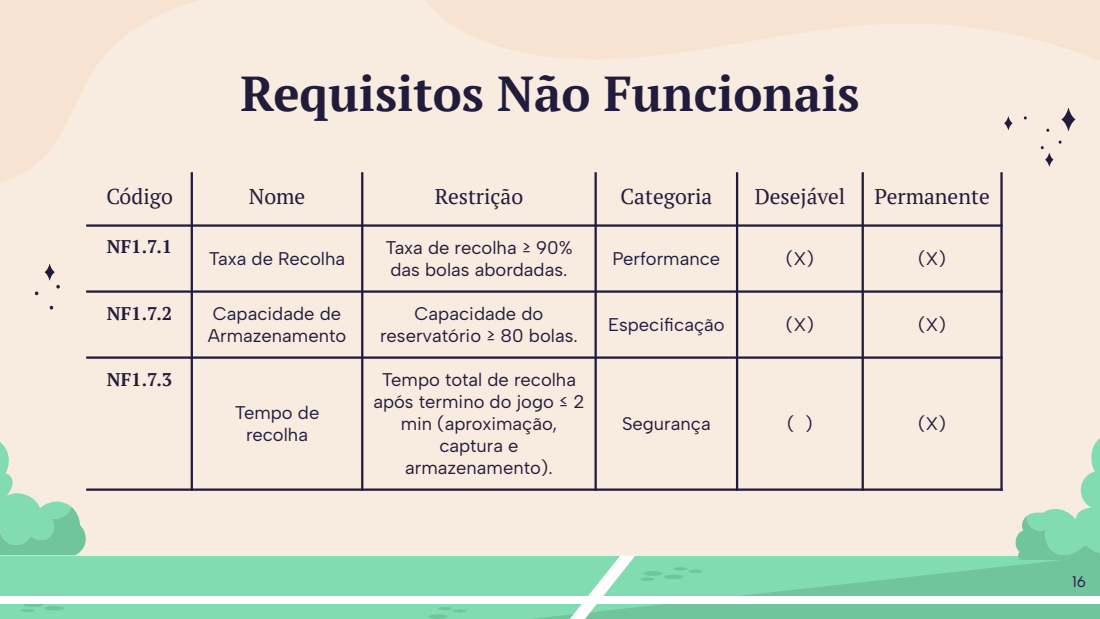
[picture p109: page 35]
Código; Nome; Restrição; Categoria; Desejável; Permanente; Taxa de Recolha; Taxa de recolha ≥ 90%; das bolas abordadas.; Performance; Capacidade de; Armazenamento; Capacidade do; reservatório ≥ 80 bolas.; Especificação; Tempo de recolha; Segurança

Tempo total de recolha
após termino do jogo ≤ 2
min (aproximação,
captura e
armazenamento).
