ECA-UFSC-FLN/2026.1-G7-RoboColetorBolas/docs/Entrega3/Entrega 3- Projeto Integrador.pdf

# Robô Coletor de

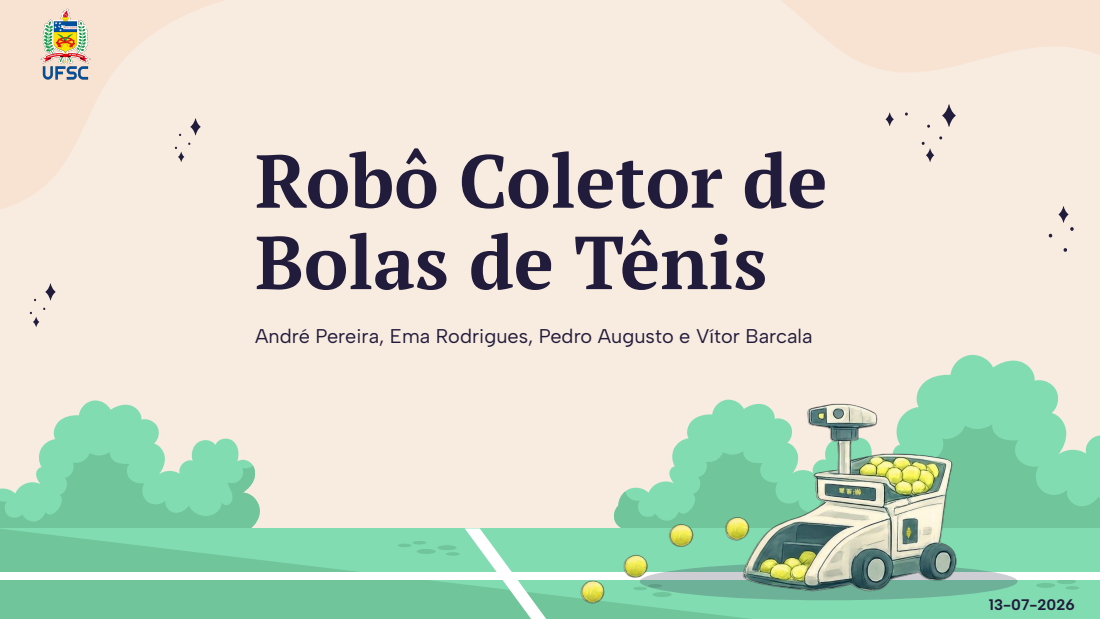
[picture p110: page 1]

Bolas de Tênis

André Pereira, Ema Rodrigues, Pedro Augusto e Vítor Barcala

# Tópicos

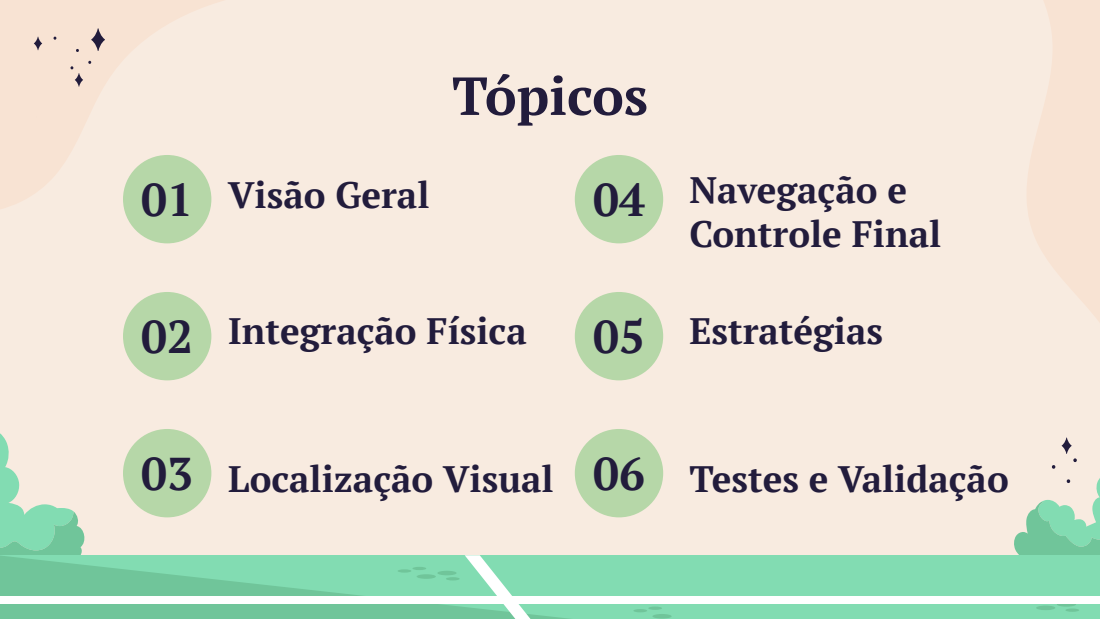
[picture p111: page 2]
Integração Física; Visão Geral; Navegação e; Controle Final; Estratégias; Localização Visual; Testes e Validação

# Tópicos

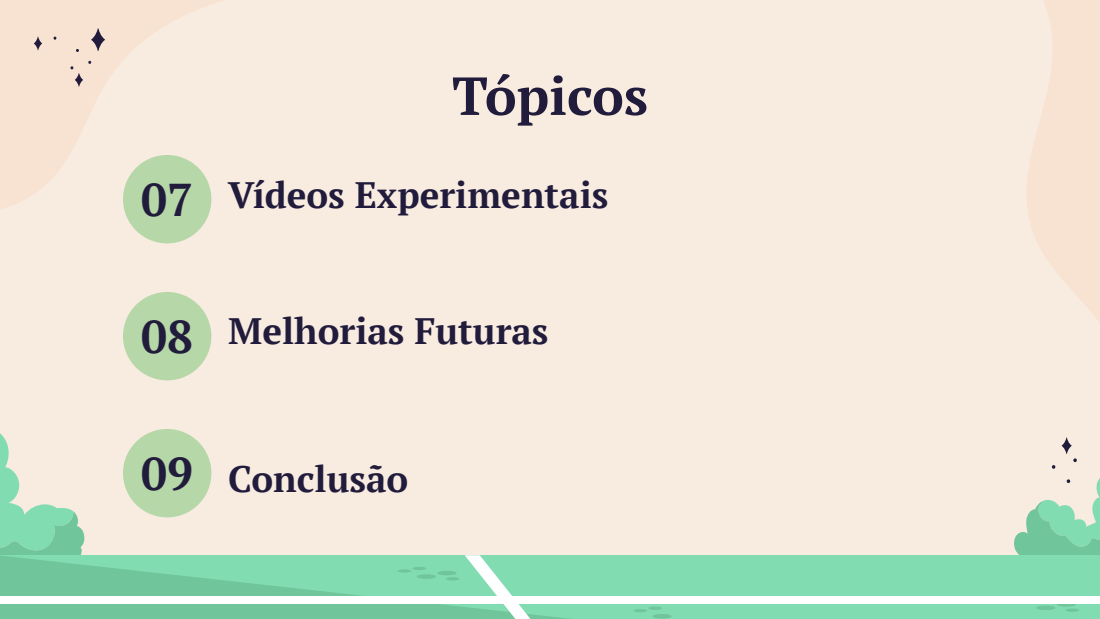
[picture p112: page 3]
Melhorias Futuras; Vídeos Experimentais; Conclusão

# Visão Geral Entrega 3

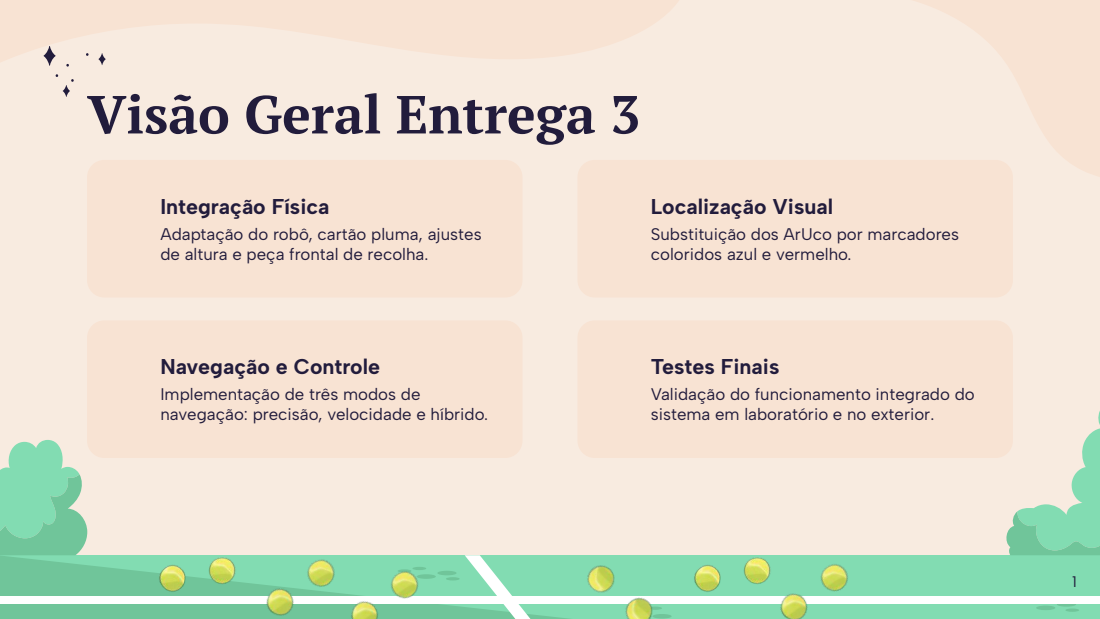
[picture p113: page 4]

Integração Física
Adaptação do robô, cartão pluma, ajustes
de altura e peça frontal de recolha.

Localização Visual
Substituição dos ArUco por marcadores
coloridos azul e vermelho.

Navegação e Controle
Implementação de três modos de
navegação: precisão, velocidade e híbrido.

Testes Finais
Validação do funcionamento integrado do
sistema em laboratório e no exterior.

# Integração Física

## Cartão Pluma

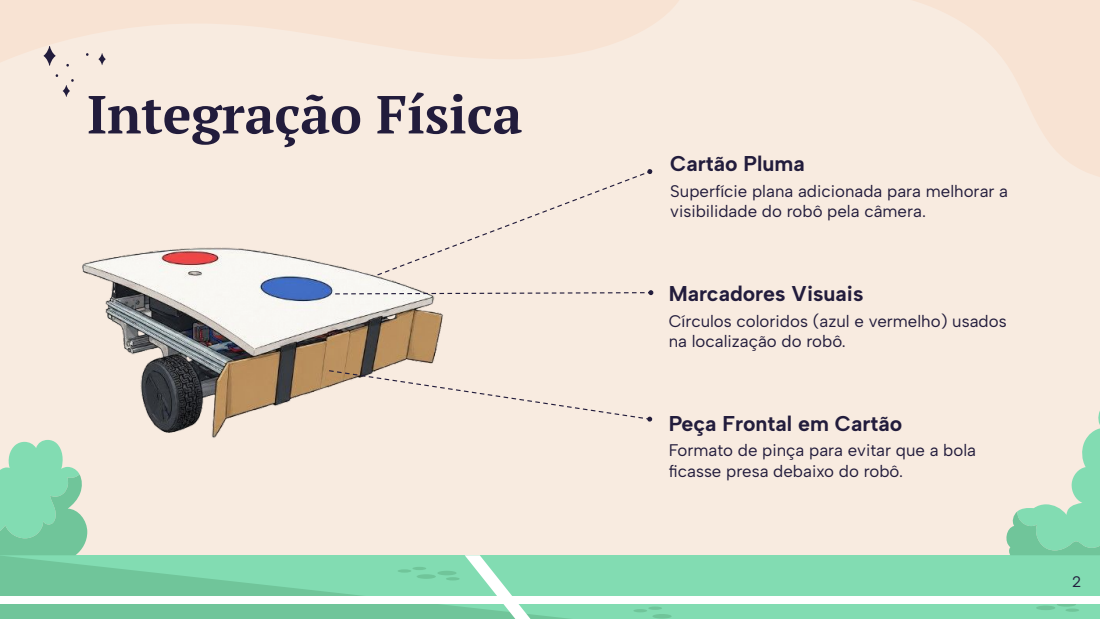
[picture p114: page 5]

Superfície plana adicionada para melhorar a
visibilidade do robô pela câmera.

Marcadores Visuais
Círculos coloridos (azul e vermelho) usados
na localização do robô.

Peça Frontal em Cartão
Formato de pinça para evitar que a bola
ficasse presa debaixo do robô.

# Localização Visual Final

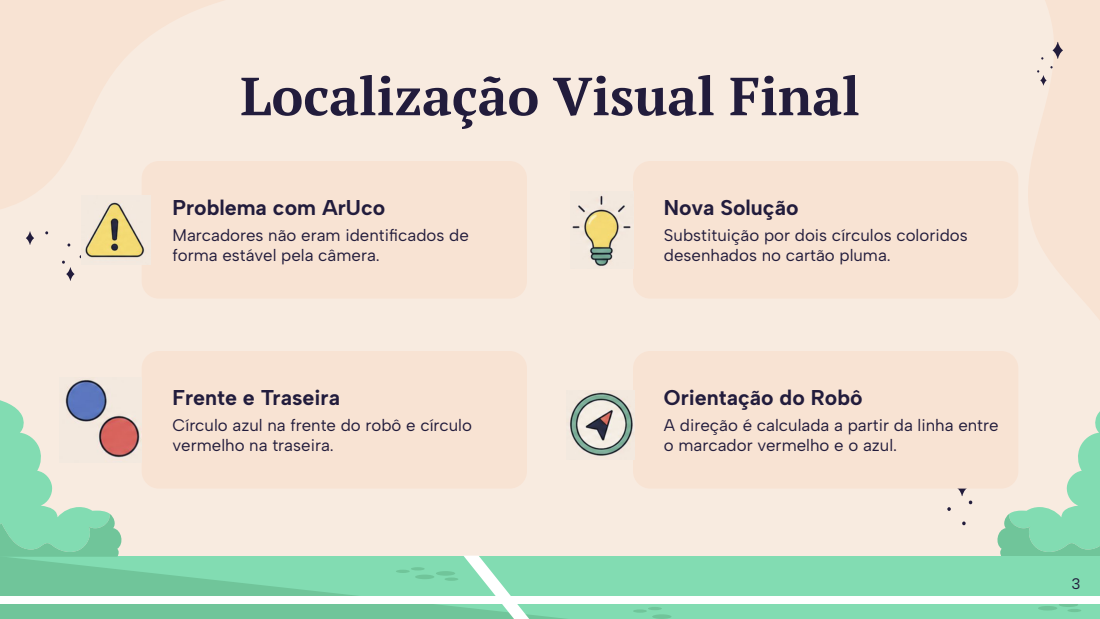
[picture p115: page 6]

Problema com ArUco
Marcadores não eram identificados de
forma estável pela câmera.

Nova Solução
Substituição por dois círculos coloridos
desenhados no cartão pluma.

Frente e Traseira
Círculo azul na frente do robô e círculo
vermelho na traseira.

Orientação do Robô
A direção é calculada a partir da linha entre
o marcador vermelho e o azul.

# Navegação e Controle Final

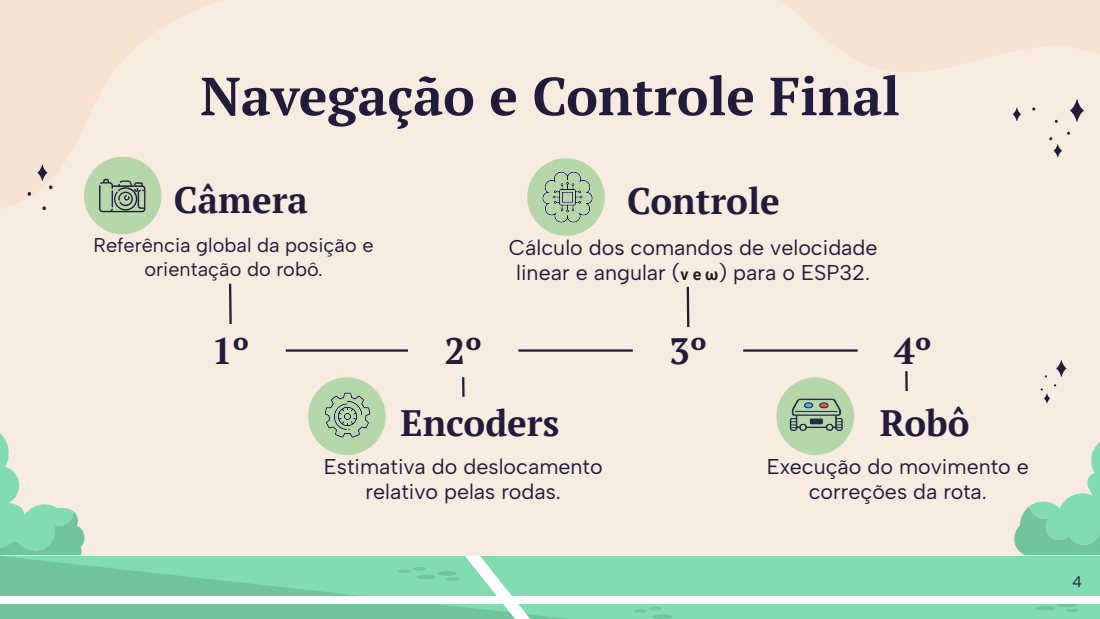
[picture p116: page 7]
Encoders; Câmera; Controle; Robô

Referência global da posição e
orientação do robô.

Cálculo dos comandos de velocidade
linear e angular (v e ω) para o ESP32.

Estimativa do deslocamento
relativo pelas rodas.

Execução do movimento e
correções da rota.

# Estratégias de Navegação

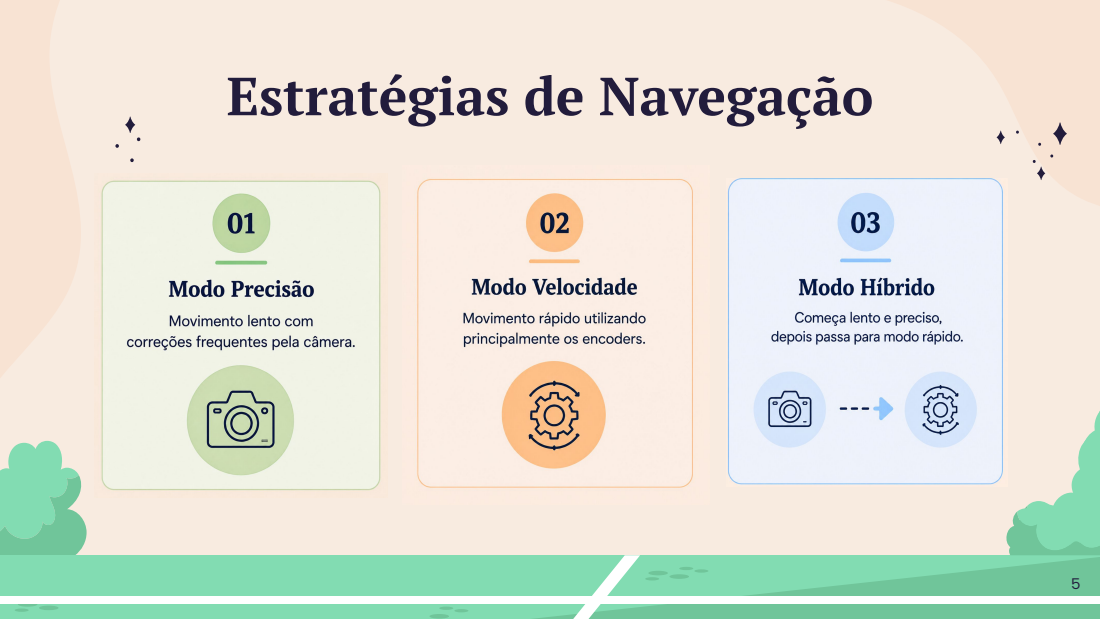
[picture p117: page 8]

# Testes Finais e Validação

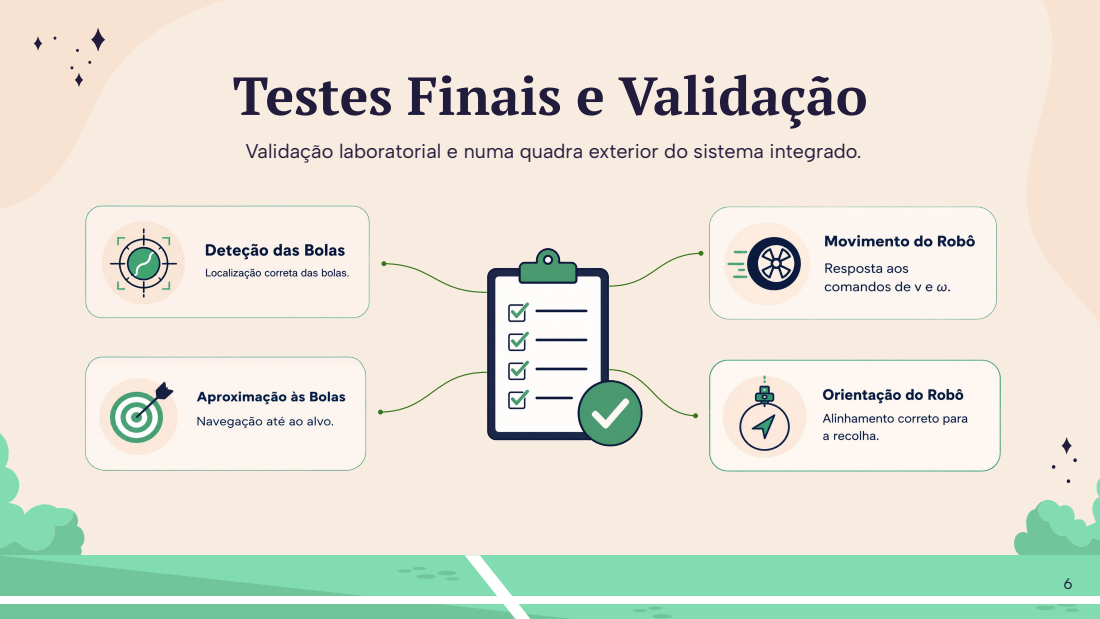
[picture p118: page 9]

Validação laboratorial e numa quadra exterior do sistema integrado.

# Vídeo Experimental - Robô no Laboratório

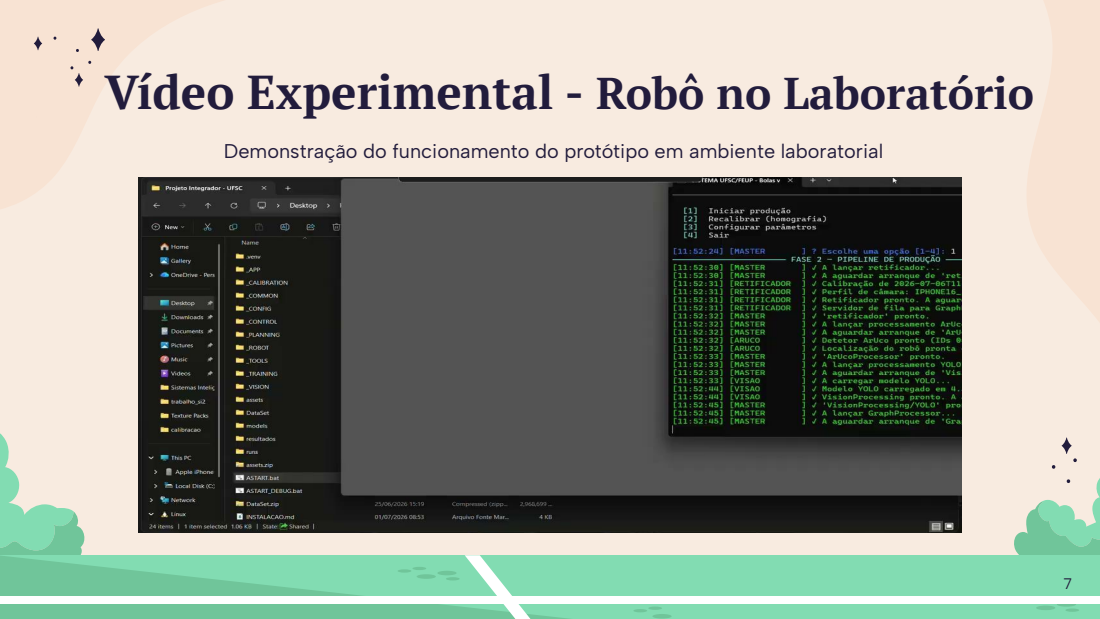
[picture p119: page 10]

Demonstração do funcionamento do protótipo em ambiente laboratorial

# Vídeo Experimental - Robô no Exterior

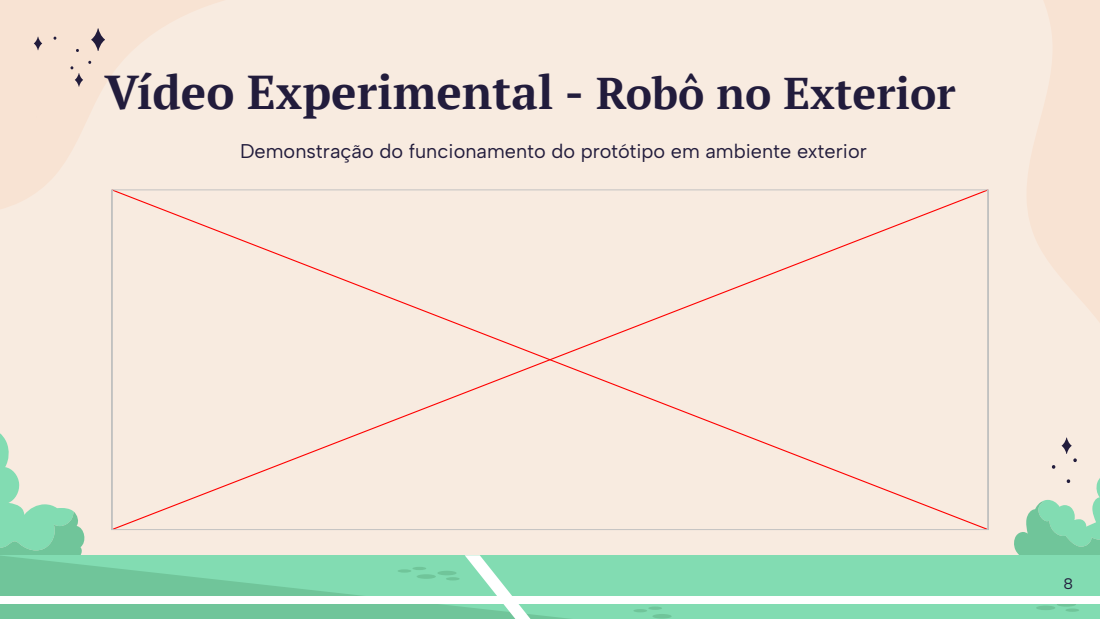
[picture p120: page 11]

Demonstração do funcionamento do protótipo em ambiente exterior

# Melhorias Futuras

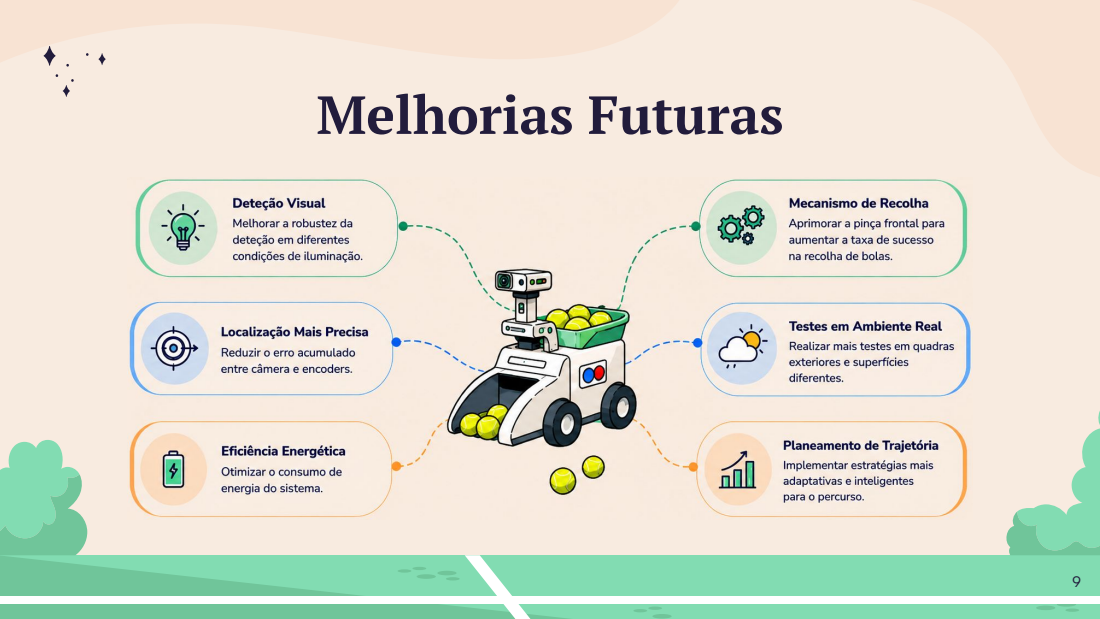
[picture p121: page 12]

# Conclusão

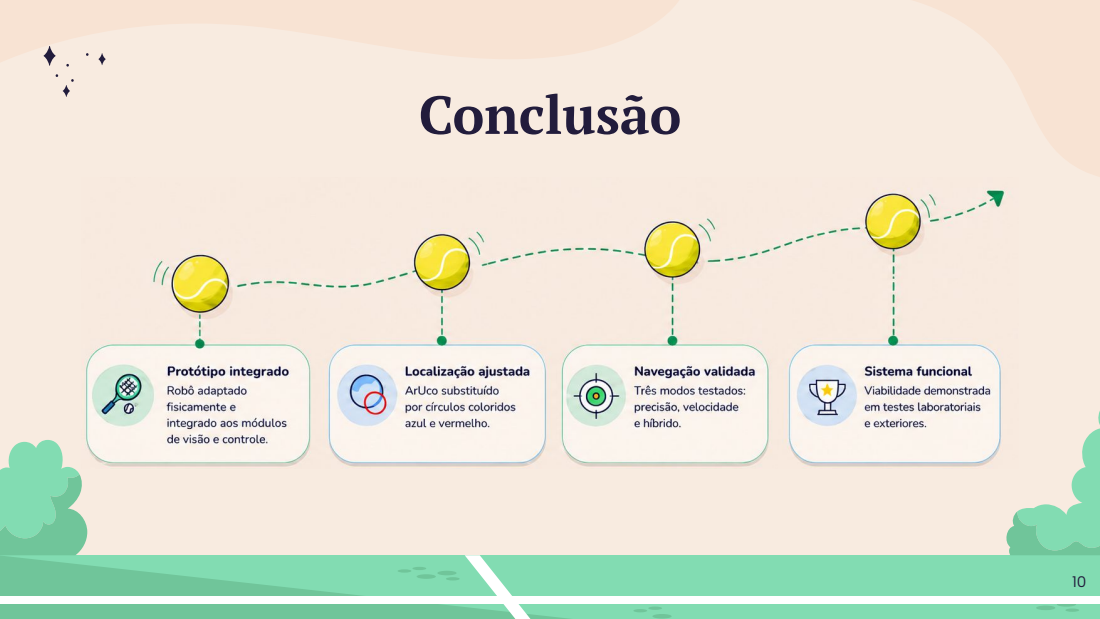
[picture p122: page 13]

# Obrigado!

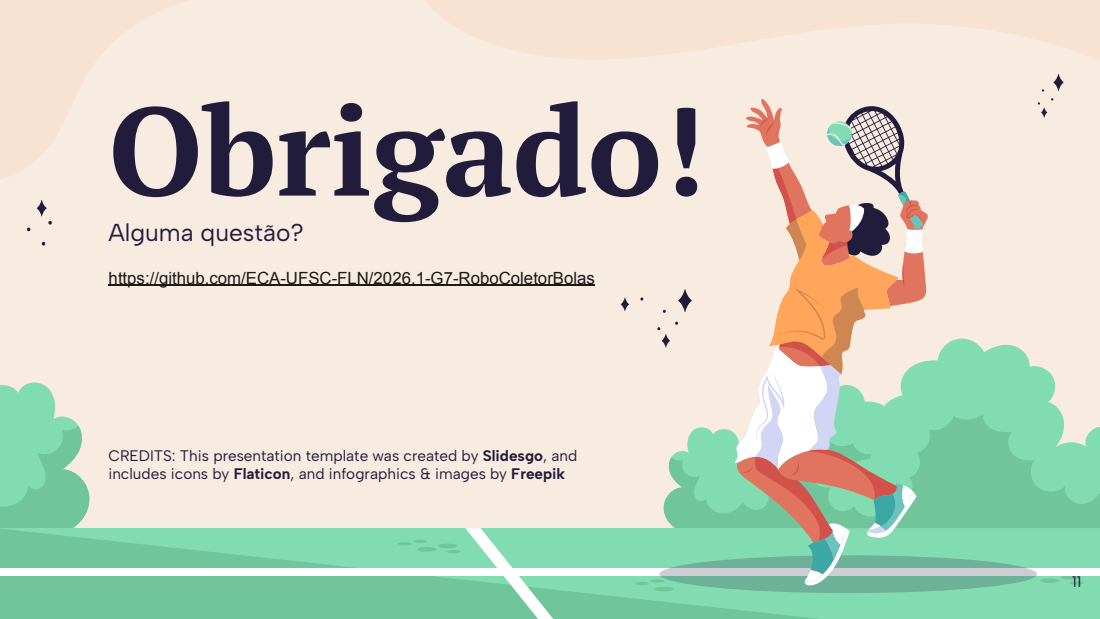
[picture p123: page 14]
Alguma questão?

https://github.com/ECA-UFSC-FLN/2026.1-G7-RoboColetorBolas

CREDITS: This presentation template was created by Slidesgo, (https://bit.ly/3A1uf1Q) and
includes icons by Flaticon, (http://bit.ly/2TyoMsr) and infographics & images by Freepik (http://bit.ly/2TtBDfr)

# 01 Drillbot

Startup de; Florianópolis - SC; Tornou-se uma; empresa em 2018

Soluções tecnológicas
para prática de ténis

Primeiros protótipos de teste
criados em 2013

# Evolução do Projeto

Funcionalidade; 1ª Entrega; 2ª Entrega; Testes preliminares; Pipeline integrado

Detecção de bolas

Calibração | Estudo inicial | Homografia implementada

Localização robô | Requisito inicial | Implementação com ArUco

Planejamento | Conceito base | Algoritmo funcional

Controle | Etapa futura | Controlador implementado

Protótipo físico | Planejamento | Montagem em andamento

# Resumo Entrega 2


Detecção de Bolas

Integração do Sistema

Integração progressiva e robusta de todos
os componentes.

Processamento no pipeline principal para
alta precisão.

Localização com ArUco

Planejamento de Trajetória
Algoritmos para otimização de rotas e
movimentos.

Rastreamento preciso do robô no ambiente
de teste.

Controle e Comunicação — Implementação de protocolos de comunicação estáveis com o robô.

# Arquitetura Geral

imageStreaming.py; VisionProcessing.py; Coordenadas métricas; retificador.py; MasterControl.py; GraphProcessor.py

Gestão de processos

Captura de imagem

Detecção de bolas e robô

Planejamento da rota
Controle do robô
RobotController.py

# Captura de Imagem


Plataforma Camo Studio
Utilização para transmissão de imagem.

Parâmetros de Calibração
Configuração de Ficheiros para correção de cada câmera

Raspberry Pi & PC
Preparação para funcionamento direto e migração futura.

# Calibração e Homografia


Correção da perspectiva da imagem
Matriz de Homografia

Seleção de pontos de referência
Mínimo 4 pontos

Conversão de pixels para coordenadas reais
Conversão para metros

Uso de matriz de homografia
Determinada com os parâmetros

Armazenamento da calibração em JSON
Necessário recalibrar sempre que se mudar a câmera

# Deteção de Bolas


Processamento de Frames
Análise em tempo real de cada quadro capturado.

Cálculo de Posição
Identificação exata das bolas dentro da imagem.

Coordenadas Métricas
Conversão de pixels para medidas do mundo real.

Integração de Trajetória
Envio de dados ao módulo de planejamento.

# Localização do Robô


Marcadores ArUco
Uso de dois marcadores para identificação.

Posicionamento Físico do Robô
Um marcador na frente e outro na traseira.

Estimativa de Posição
Localização precisa no plano da quadra.

Cálculo de Orientação
Determinação da direção do robô.

# Planejamento da Trajetória

_numbe

Entrada de Dados
Recebe posição do robô e das bolas.

Sequenciamento
Define a sequência de recolha das bolas.

Modo Global
Trajetória baseada em todas as bolas da quadra.

Modo de Faixas
Escolha de objetivo baseada no peso das faixas.

# Vídeo Experimental


# Vídeo Experimental


# Controle de Robô


Erro de Posição e Angular
Cálculo preciso dos desvios para correção de rota.

Definição de Velocidades
Ajuste de velocidade linear e angular do robô.

Controle PID Angular
Algoritmo para estabilização da orientação.

Comunicação UDP
Envio de comandos sem fio para o ESP32.

# Protótipo Físico

List_numbeg Testes Práticos

Montagem
Montagem do robô iniciada.

Integração ESP32
Preparação para integração com ESP32.

Integração Física
Integração física ainda em andamento.

Testes previstos com montagem da bateria.

# Vídeo Experimental


# Cronograma (Atual)


# Próximas Etapas


# Cronograma (Espectável)


Slides antigos

# Tecnologia Atual Drillbot

130 bolas

Capacidade da Máquina
2-4 segundos

Intervalo entre Lançamento
~7 minutos

Tempo Total (intervalo de 3s)

# 03 Solução Proposta

bolinhas; bolas; Robô coletor; Sistema de câmera(s)

Um robô autônomo que se
deslocaria pela quadra recolhendo

Câmera(s) posicionada(s) pela
quadra localizariam as bolas e
guiariam o robô para coletar as

# 04 Funcionamento do Sistema

# Coordenadas

Percurso

Transmissão
Transmissão do percurso
para o RP

Cálculo das coordenadas via os
algoritmos de VC e Distorção

Deslocamento
Robô move-se até as
posições e retorna a um
estado de repouso (espera)

Algoritmo de trajetória ideal
com base nas coordenadas

Árvore de Funcionalidades

# 05 Requisitos

Oculto()

F1.3 Localização do Robô na Quadra (Odometria)
Estimar, em tempo real, a posição e orientação do robô na quadra usando encoders, IMU
e/ou visão.

# Requisitos Não Funcionais

Código; Nome; Restrição; Categoria; Desejável; Permanente; Precisão de; Localização; por metro percorrido.; Performance; Frequência de; Atualização; cada 100 ms.; Recuperação; de Deriva; Especificação

Erro de posição ≤ 3 cm

Atualização da posição a

Uso de referências fixas
da quadra para corrigir
deriva da odometria.

# 05 Requisitos

Oculto()

F1.4 Detectar e Localizar Bolas de Ténis
Detectar bolas e estimar a sua posição 2D na quadra via visão computacional.

# Requisitos Não Funcionais

Código; Nome; Restrição; Categoria; Desejável; Permanente; Taxa de Detecção; Performance; Diferenciação; de Objetos; outros objetos na quadra.; Interface; Latência de; Detecção

Detectar bolas com
precisão sob iluminação
normal (500–1000 lux) e
velocidades < 1 m/s.

Distinguir bolas de tênis de

Latência < 200 ms entre
captura da imagem e
posição da bola.

# 05 Requisitos

Oculto(X)

F1.6 Planejamento de Trajetórias
Calcular a sequência ótima de recolha e o percurso mais eficiente, evitando obstáculos.

# Requisitos Não Funcionais

Código; Nome; Restrição; Categoria; Desejável; Permanente; Algoritmo de; Otimização; Especificação; Tempo de; Cálculo; calculado em ≤ 3 s.; Performance; Replanificação

Usar algoritmo de
otimização para ordenar a
recolha das bolas.

Plano de trajetória

Replanificar trajetória ao
detetar ≥3 bolas em 1 m
ou obstáculo ≤0,5 m.

# 05 Requisitos

Oculto( )

F1.7 Recolher Bolas do Chão
Recolher e armazenar bolas automaticamente ao aproximar-se.

# Requisitos Não Funcionais

Código; Nome; Restrição; Categoria; Desejável; Permanente; Taxa de Recolha; Taxa de recolha ≥ 90%; das bolas abordadas.; Performance; Capacidade de; Armazenamento; Capacidade do; reservatório ≥ 80 bolas.; Especificação; Tempo de recolha; Segurança

Tempo total de recolha
após termino do jogo ≤ 2
min (aproximação,
captura e
armazenamento).
