ECA-UFSC-FLN/2026.1-G7-RoboColetorBolas/docs/Entrega 1/Entrega 1 - Projeto Integrador.pdf

# Robô Coletor de

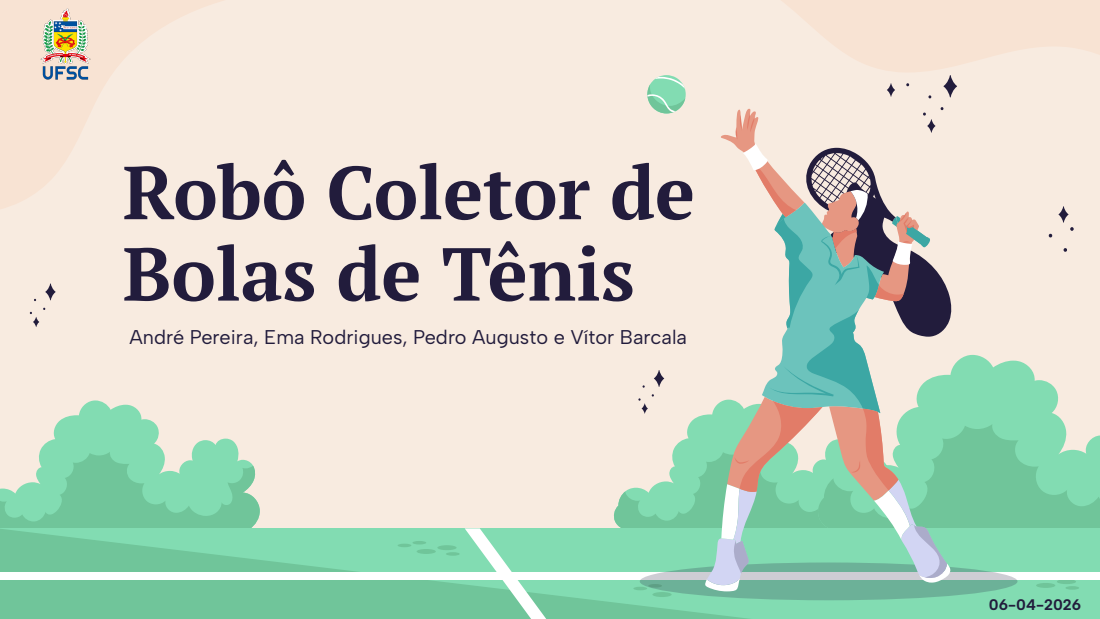
[picture p124: page 1]

Bolas de Tênis

André Pereira, Ema Rodrigues, Pedro Augusto e Vítor Barcala

# Tópicos

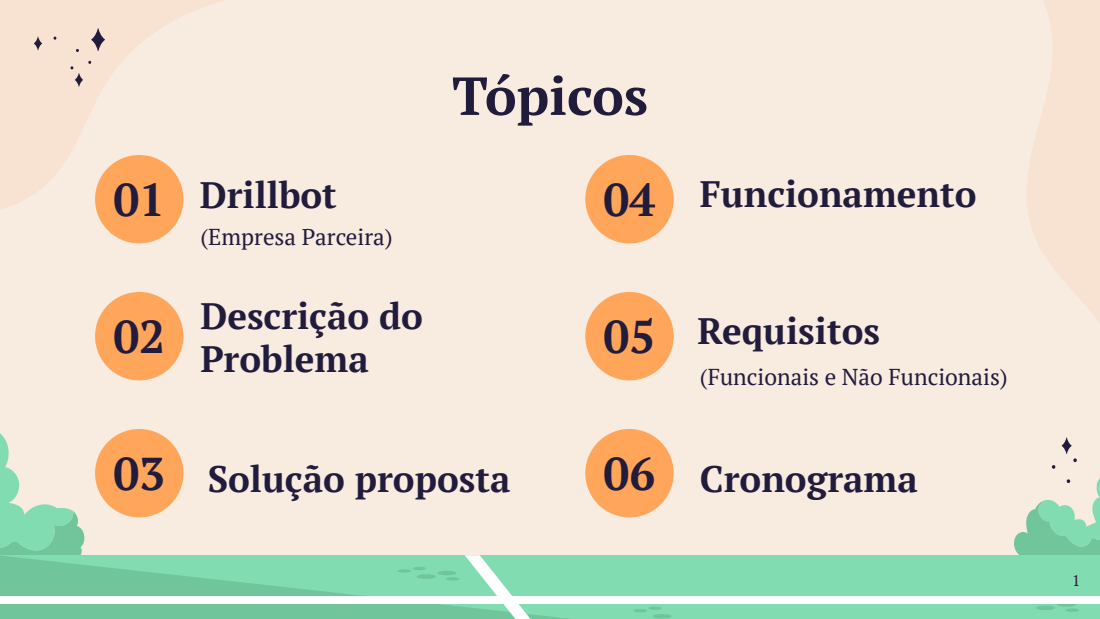
[picture p125: page 2]
Descrição do Problema; Drillbot; Funcionamento; Solução proposta; Cronograma; (Empresa Parceira)

Requisitos
(Funcionais e Não Funcionais)

# 01 Drillbot

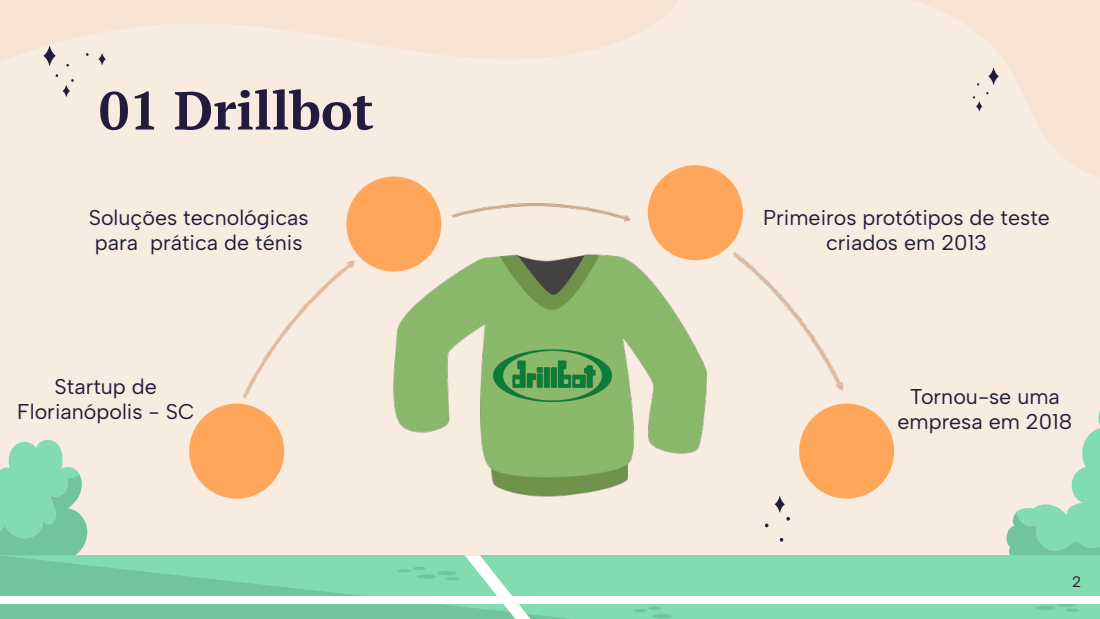
[picture p126: page 3]
Startup de; Florianópolis - SC; Tornou-se uma; empresa em 2018

Soluções tecnológicas
para prática de ténis

Primeiros protótipos de teste
criados em 2013

# Tecnologia Atual Drillbot

130 bolas

Capacidade da Máquina
2-4 segundos

Intervalo entre Lançamento
~7 minutos

Tempo Total (intervalo de 3s)

# 03 Solução Proposta

bolinhas; bolas; Robô coletor; Sistema de câmera(s)

Um robô autônomo que se
deslocaria pela quadra recolhendo

Câmera(s) posicionada(s) pela
quadra localizariam as bolas e
guiariam o robô para coletar as

# 04 Funcionamento do Sistema

# Captura de Imagem

captada

Processamento
Processamento da imagem
pelo algoritmo de Visão
Computacional

Com recurso à câmera externa,
uma imagem da quadra é
Transmissão

Distorção
Remover a distorção
da câmera e do
ângulo de captura

Transmissão da imagem
captada da câmera para o
PC / Raspberry Pi

# 04 Funcionamento do Sistema

# Coordenadas

Percurso

Transmissão
Transmissão do percurso
para o RP

Cálculo das coordenadas via os
algoritmos de VC e Distorção

Deslocamento
Robô move-se até as
posições e retorna a um
estado de repouso (espera)

Algoritmo de trajetória ideal
com base nas coordenadas

Árvore de Funcionalidades

# 05 Requisitos

Oculto()

F1.3 Localização do Robô na Quadra (Odometria)
Estimar, em tempo real, a posição e orientação do robô na quadra usando encoders, IMU
e/ou visão.

# Requisitos Não Funcionais

Código; Nome; Restrição; Categoria; Desejável; Permanente; Precisão de; Localização; por metro percorrido.; Performance; Frequência de; Atualização; cada 100 ms.; Recuperação; de Deriva; Especificação

Erro de posição ≤ 3 cm

Atualização da posição a

Uso de referências fixas
da quadra para corrigir
deriva da odometria.

# 05 Requisitos

Oculto()

F1.4 Detectar e Localizar Bolas de Ténis
Detectar bolas e estimar a sua posição 2D na quadra via visão computacional.

# Requisitos Não Funcionais

Código; Nome; Restrição; Categoria; Desejável; Permanente; Taxa de Detecção; Performance; Diferenciação; de Objetos; outros objetos na quadra.; Interface; Latência de; Detecção

Detectar bolas com
precisão sob iluminação
normal (500–1000 lux) e
velocidades < 1 m/s.

Distinguir bolas de tênis de

Latência < 200 ms entre
captura da imagem e
posição da bola.

# 05 Requisitos

Oculto(X)

F1.6 Planejamento de Trajetórias
Calcular a sequência ótima de recolha e o percurso mais eficiente, evitando obstáculos.

# Requisitos Não Funcionais

Código; Nome; Restrição; Categoria; Desejável; Permanente; Algoritmo de; Otimização; Especificação; Tempo de; Cálculo; calculado em ≤ 3 s.; Performance; Replanificação

Usar algoritmo de
otimização para ordenar a
recolha das bolas.

Plano de trajetória

Replanificar trajetória ao
detetar ≥3 bolas em 1 m
ou obstáculo ≤0,5 m.

# 05 Requisitos

Oculto( )

F1.7 Recolher Bolas do Chão
Recolher e armazenar bolas automaticamente ao aproximar-se.

# Requisitos Não Funcionais

Código; Nome; Restrição; Categoria; Desejável; Permanente; Taxa de Recolha; Taxa de recolha ≥ 90%; das bolas abordadas.; Performance; Capacidade de; Armazenamento; Capacidade do; reservatório ≥ 80 bolas.; Especificação; Tempo de recolha; Segurança

Tempo total de recolha
após termino do jogo ≤ 2
min (aproximação,
captura e
armazenamento).

# Cronograma (Atual)

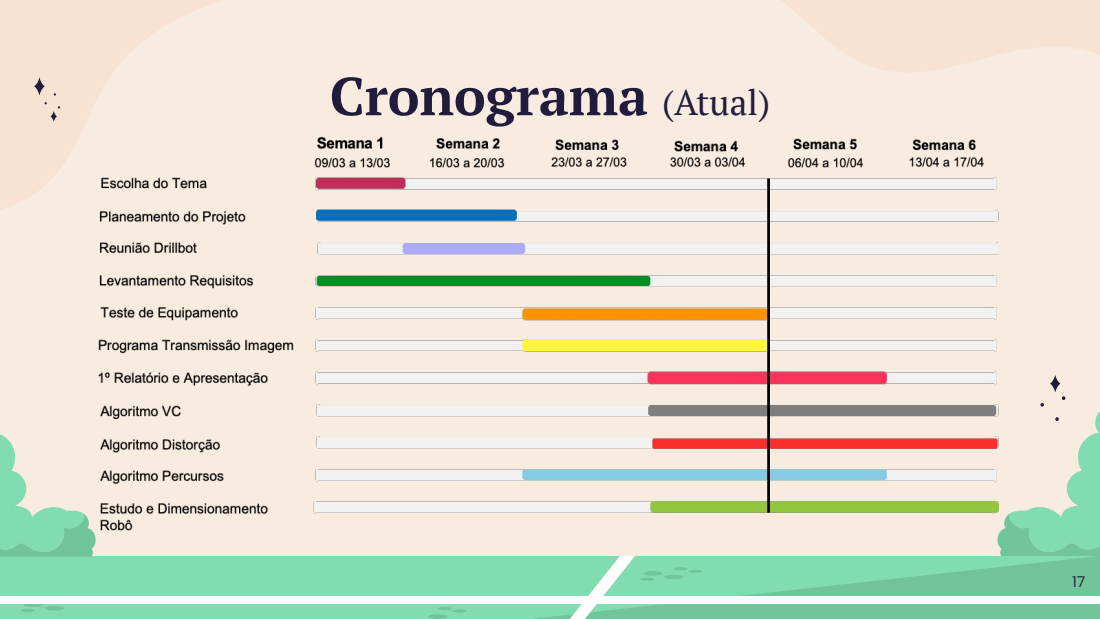
[picture p127: page 17]

# Cronograma (Espectável)

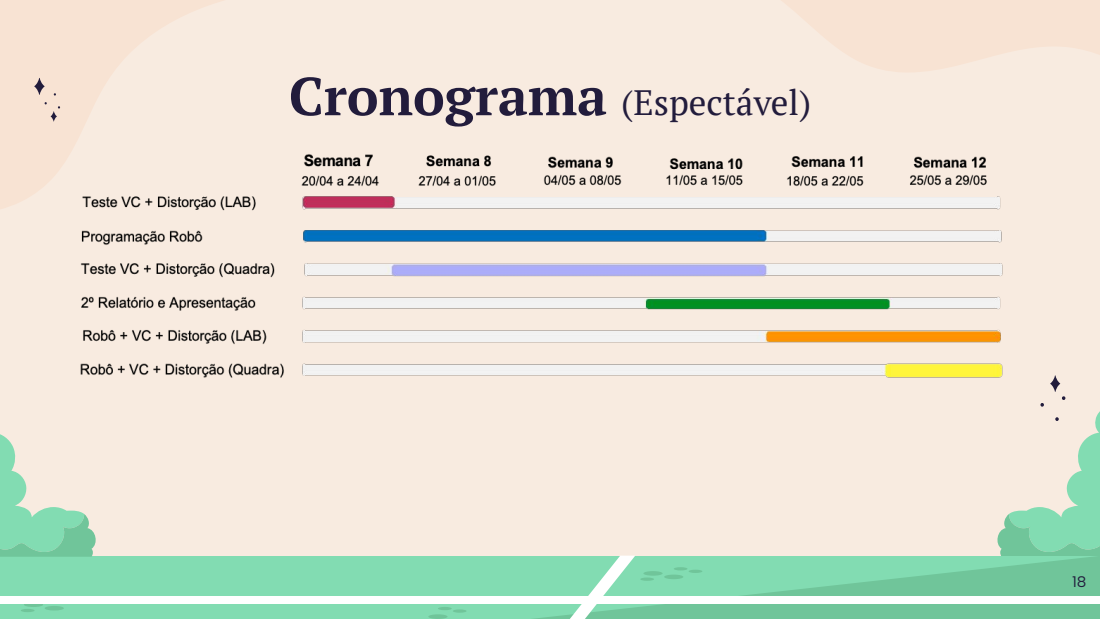
[picture p128: page 18]

# Obrigado!

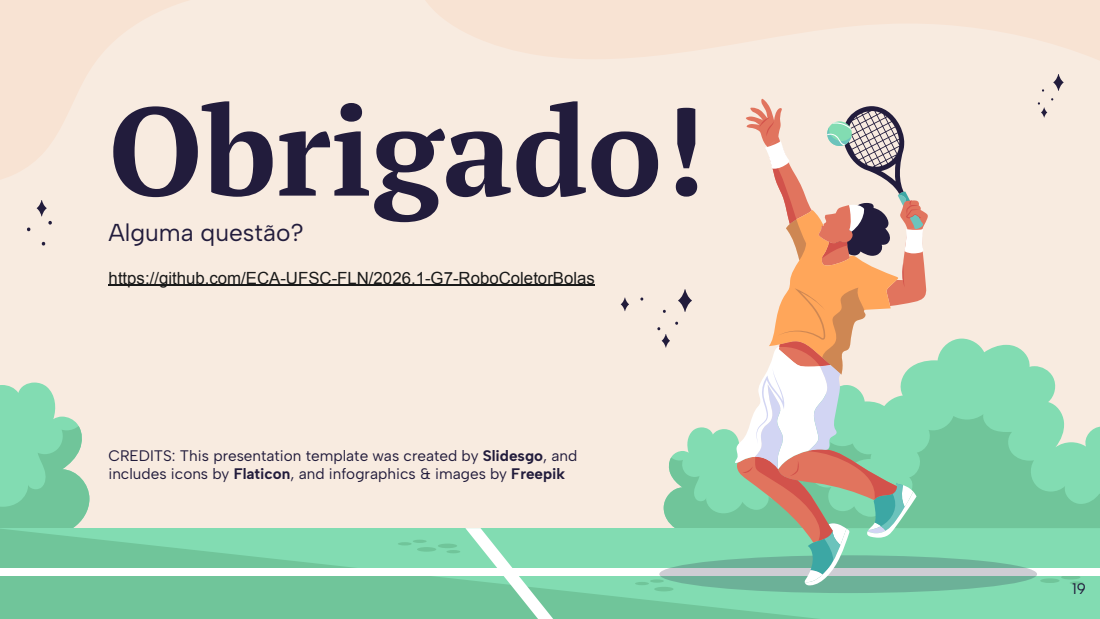
[picture p129: page 19]
Alguma questão?

https://github.com/ECA-UFSC-FLN/2026.1-G7-RoboColetorBolas

CREDITS: This presentation template was created by Slidesgo, (https://bit.ly/3A1uf1Q) and
includes icons by Flaticon, (http://bit.ly/2TyoMsr) and infographics & images by Freepik (http://bit.ly/2TtBDfr)
