ECA-UFSC-FLN/2026.1-G7-RoboColetorBolas/(commit log)

2026-04-02 Add files via upload
    Programa Utilizado para fazer stream de imagens do celular (telemóvel) para o PC
2026-04-02 Add files via upload
    Programa de treinamento do modelo de Visão Computacional
2026-04-02 Add files via upload
    Programa que identifica os objetos (bolas de tenis): mapeia a posição de cada um e enumera o número de objetos detetados
2026-04-02 Update and rename TestVision.py to TestVision - Deteção da posição e enumera o número de bolinhas.py
    Alteração do nome do ficheiro
2026-04-02 Rename VisionTraining.py to VisionTraining - Algoritmo de treino de Visão Computacional.py
    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
2026-04-02 Rename imageStreaming.py to ImageStreaming - Programa de Streaming entre Celular e PC .py
    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
2026-04-02 Rename TestVision - Deteção da posição e enumera o número de bolinhas.py to TestVision - Deteção da posição e enumeração do número de bolinhas.py
    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
2026-04-09 Criar novo Folder para Códigos de Distorção
2026-04-09 Add files via upload
    Corrige a distorção da câmara e a perspetiva de uma imagem, produzindo uma vista "de cima" com origem (0,0) no canto superior esquerdo.
2026-04-09 Create Árvore de Funcionalidades
2026-04-09 Add files via upload
    Árvore de Funcionalidades
2026-04-09 Add files via upload
    Requisitos Funcionais (RF) e Não Funcionais (NF) -> Alguns requisitos incluem variáveis indicadas pelo símbolo “X”. Estes valores serão definidos posteriormente, durante a fase de testes e calibração do protótipo.
    [Tabela_Funcionalidades.xlsx]
2026-04-10 Add files via upload
    Relatório 1 entregue a 09 de abril de 2026.
2026-04-10 Add files via upload
    Apresentação 1 realizada a 06 de abril de 2026.
2026-04-13 Alteração aos ficheiros de ImageStreaming e VisionProcessing de modo a comunicarem entre ambos com semáforos. Atualizaçao do novo modelo de Visao Computacional.
2026-04-13 Update retificador.py
    Conversão de coordenadas em pixels para coordenadas reais
2026-04-15 -Atualização dos ficheiros de streaming de imagem e processamento de visão para funcionarem de forma integrada. -Adição do ficheiro de Master Control para gerir o fluxo entre programas.
2026-04-22 -Atualização dos algoritmos de modo a funcionar de forma síncrona e (de forma complementar) com um timer de 5 segundos entre caputuras de imagens.
2026-04-22 - Eliminação de caminhos hardcoded, adição de logging estruturado com cores e timestamps; - Servidor de health-check na porta 6011; - Melhoria da UI de calibração com erro de reprojeção - Separação d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
2026-04-27 . Melhoria da comunicação com os códigos anteriores;
    . Retificação da imagem com as bolas para efeitos de teste;
2026-04-27 Correção de bugs na comunicação entre programas de modo a tornar os sistemas independentes mais confiáveis e mais facilmente corrigíveis através de prints sucessivos do estado atual no temrinal
2026-04-30 Integração dos códigos de modo a produzirem uma trajetória.
2026-05-20 Replace src with current robot collector pipeline
    [results.csv]
2026-05-21 Reduce ArUco latency and fix debug topdown frames
2026-05-28 Move robot control supervision to ESP32 protocol
2026-07-01 Publish current pipeline models and setup guide
2026-07-01 Add Xiaomi Mi 9T camera profile
2026-07-06 Add configurable ESP32 orientation correction mode
    [robo_coletor_esp32.ino]
2026-07-08 Improve camera-supervised sweeps and add vision recovery
2026-07-13 Rename docs/PI_Entrega3_compressed.pdf to docs/Entrega3/PI_Entrega3_compressed.pdf
    Move relatório da Entrega 3 para pasta Entrega3
